Pablo-Jean/Antares-Transmitter-HWR/Output/1.0.2/3D/Antares-Transmitter.png

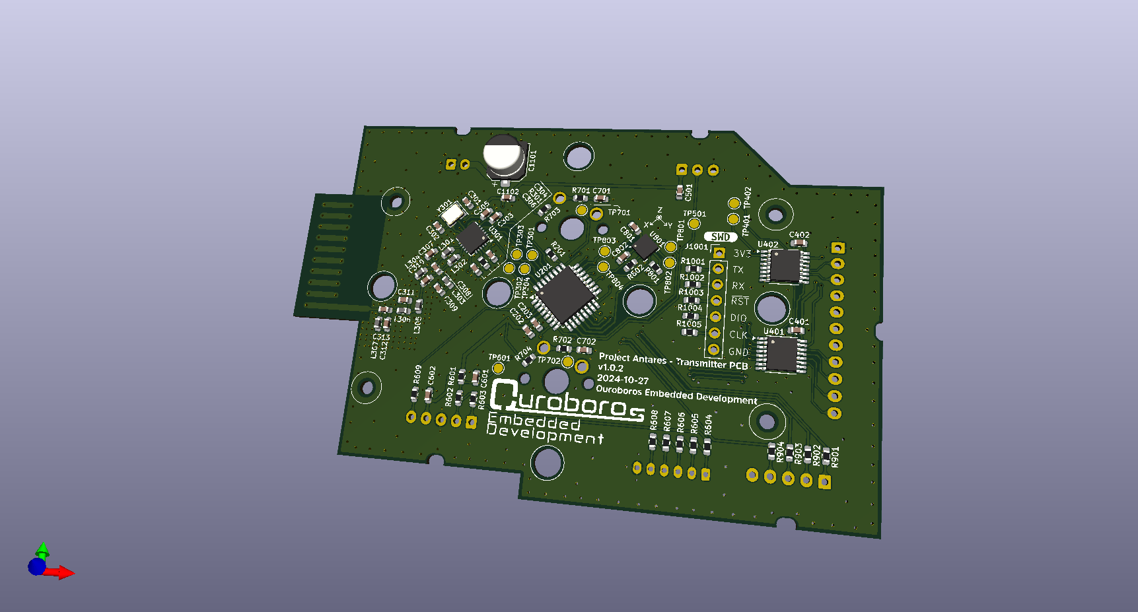
Output/1.0.2/3D/Antares-Transmitter.png
