Pablo-Jean/Antares-Transmitter-HWR/Calcs/Notes Btn An Calculations.ods

Sheet: Notes
Vin | R1 | R2 | R3 | R4 | R5 | R6 | R7 | R8 | R9 | R10 | R11
3,3 | 22 | 1 | 2,2 | 3,3 | 3,3 | 3,3 | 4,7 | 5,6 | 10 | 10 | 22
Chave | Tensão | Diferença
SW1 | 0,143 | 0,275569358178054
SW2 | 0,419 | 0,333583959899749
SW3 | 0,753 | 0,264349553128103
SW4 | 1,017 | 0,21464279954846
SW5 | 1,232 | 0,244255465360993
SW6 | 1,476 | 0,225001660283798
SW7 | 1,701 | 0,288649628651855
SW8 | 1,990 | 0,200377570960156
SW9 | 2,190 | 0,279428127558626
SW10 | 2,469

Sheet: Control
Vin | R1 | R2 | R3 | R4 | R5 | R6 | R7 | R8
3,3 | 10 | 1 | 2,2 | 3,3 | 5,6 | 5,6 | 10 | 22
Chave | Tensão | Diferença
SW1 | 0,300 | 0,5
SW2 | 0,800 | 0,5
SW3 | 1,300 | 0,506787330316742
SW4 | 1,807 | 0,301876929611056
SW5 | 2,109 | 0,316004175085465
SW6 | 2,425 | 0,32256774589126
SW7 | 2,747
