Pablo-Jean/Antares-Transmitter-HWR/Output/1.0.2/Schematic/Project Antares Transmitter Schematic v1.0.2.pdf

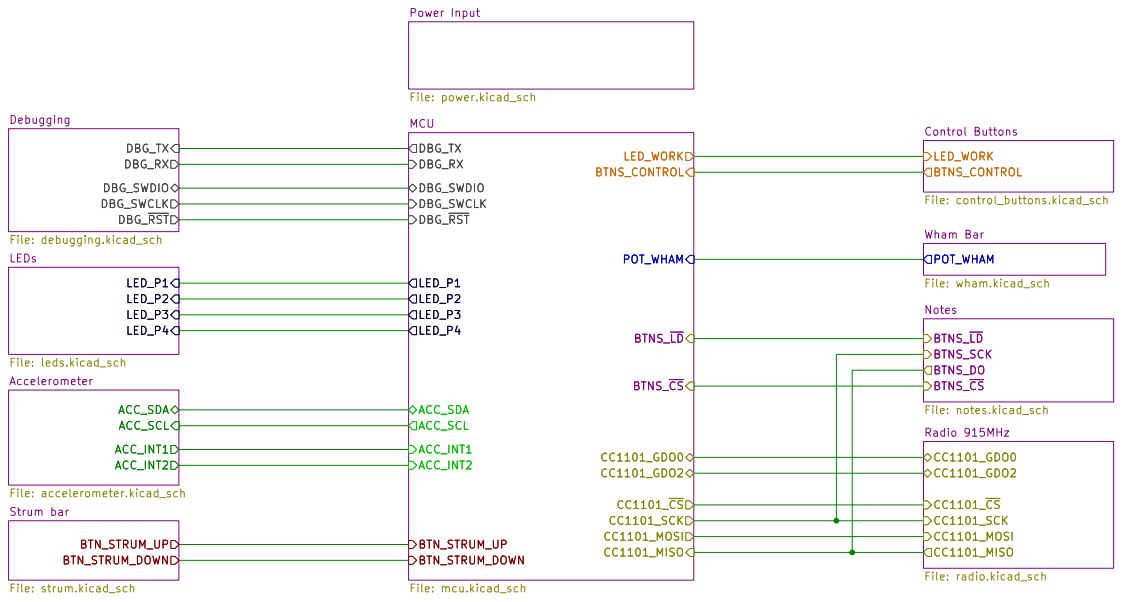
[picture p2: page 1]

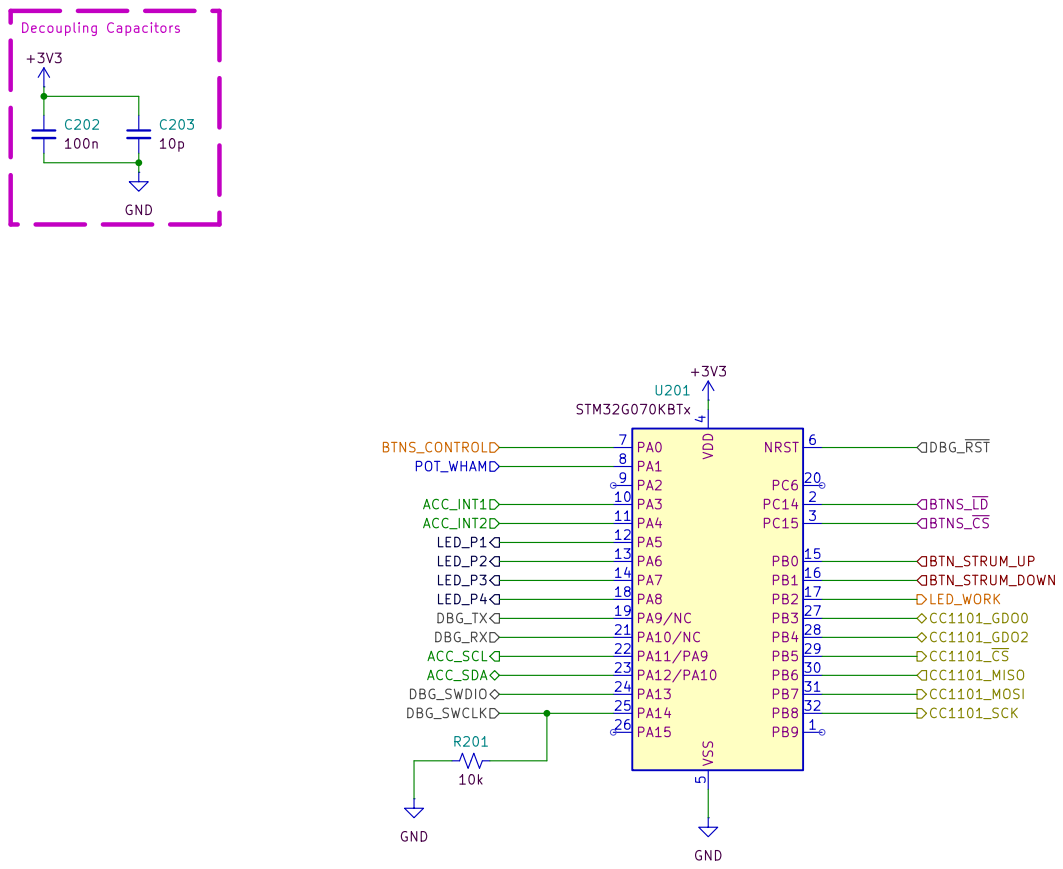
[picture p3: page 2]

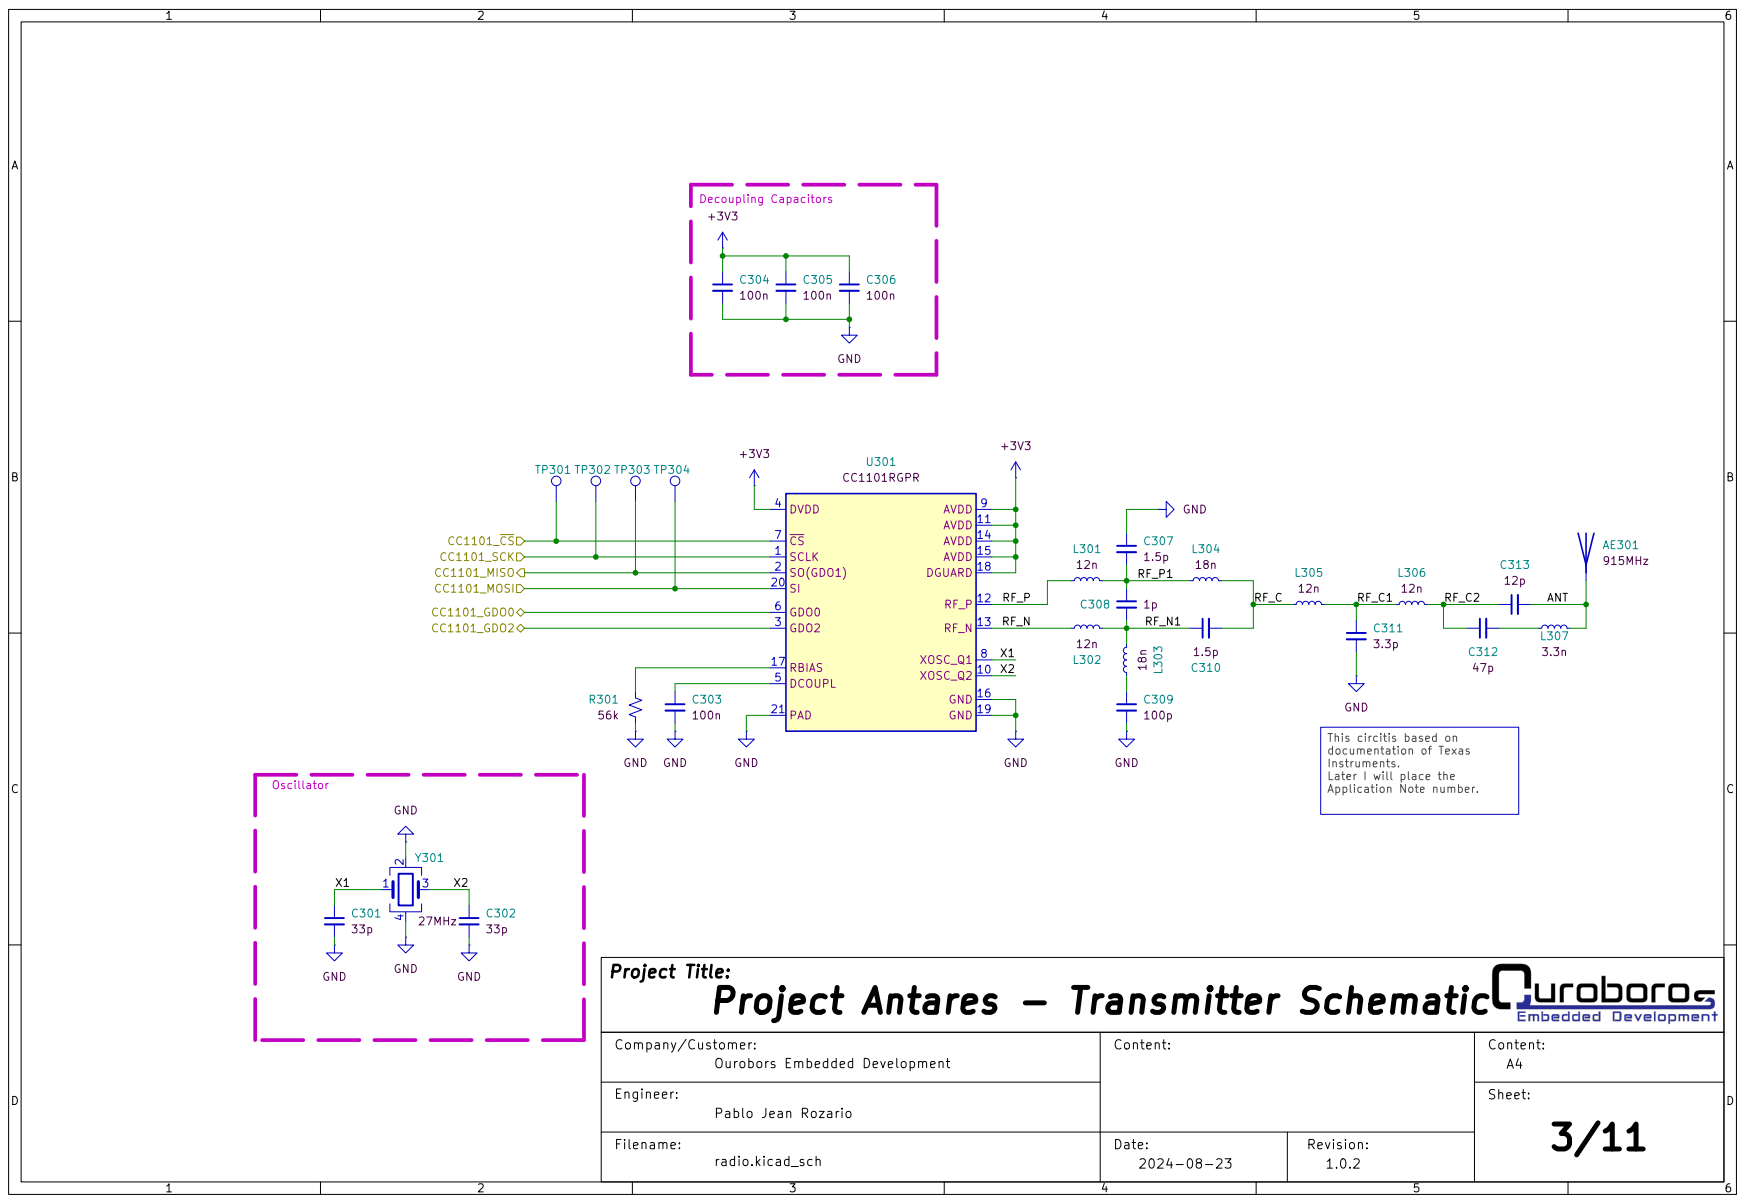
[picture p4: page 3]

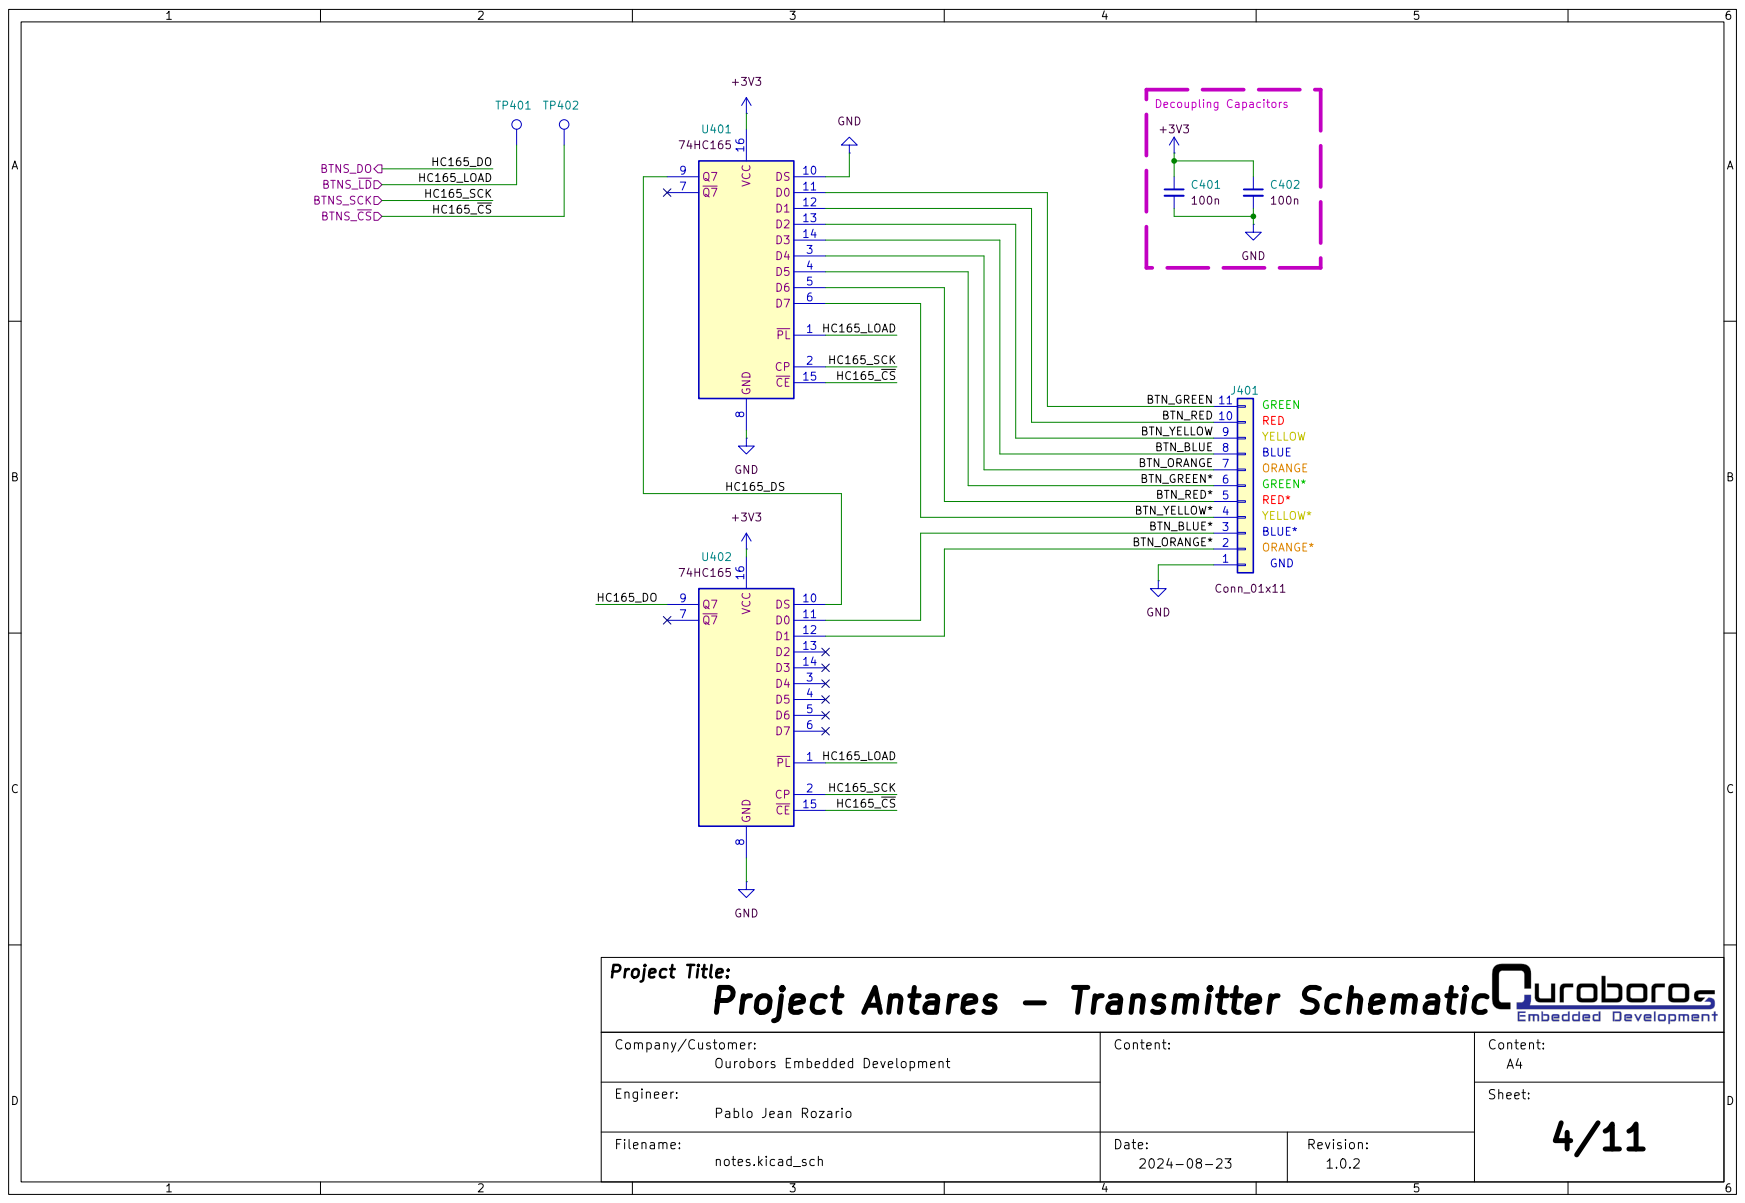
[picture p5: page 4]

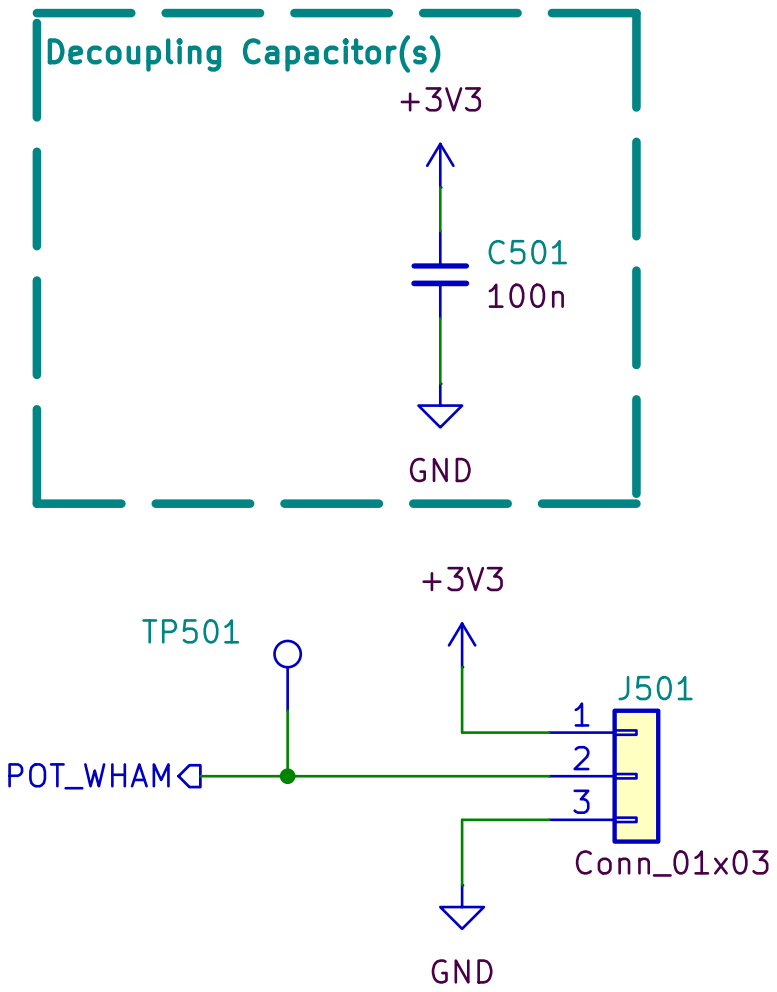
[picture p6: page 5]

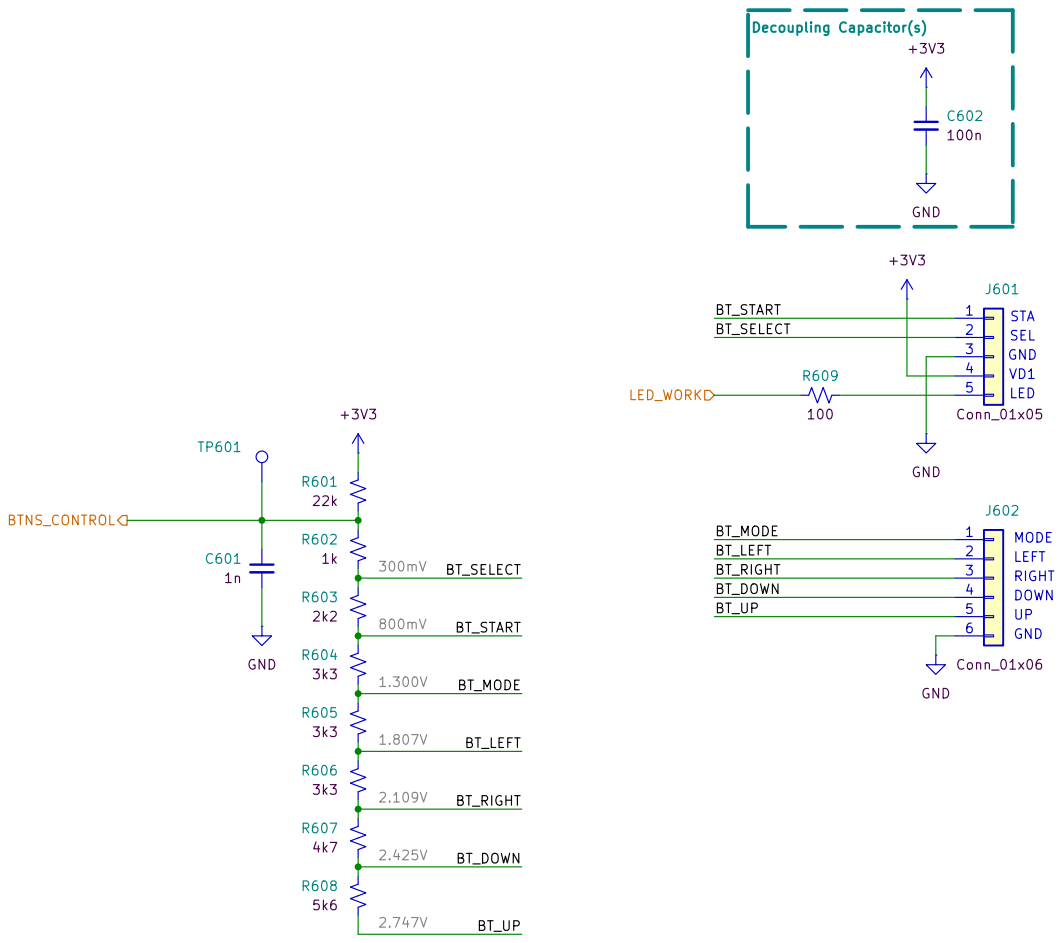
[picture p7: page 6]

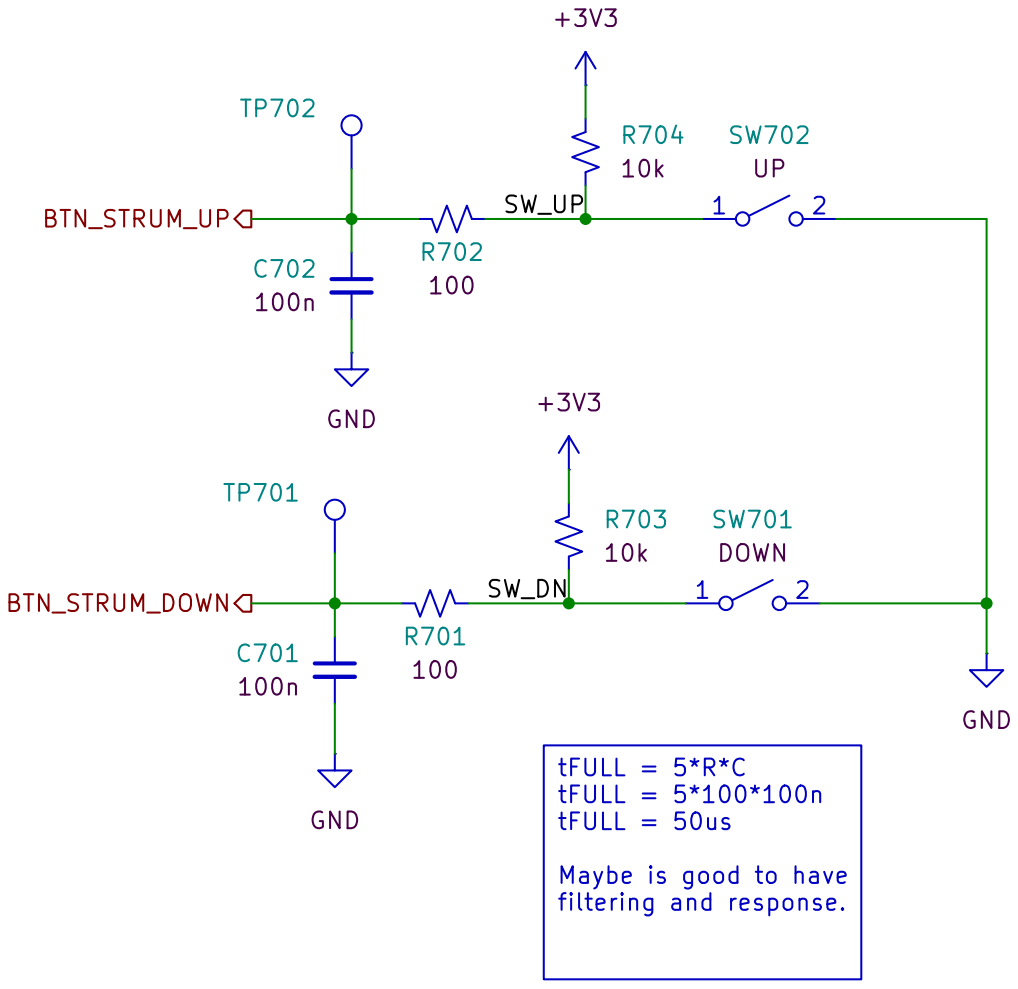
[picture p8: page 7]

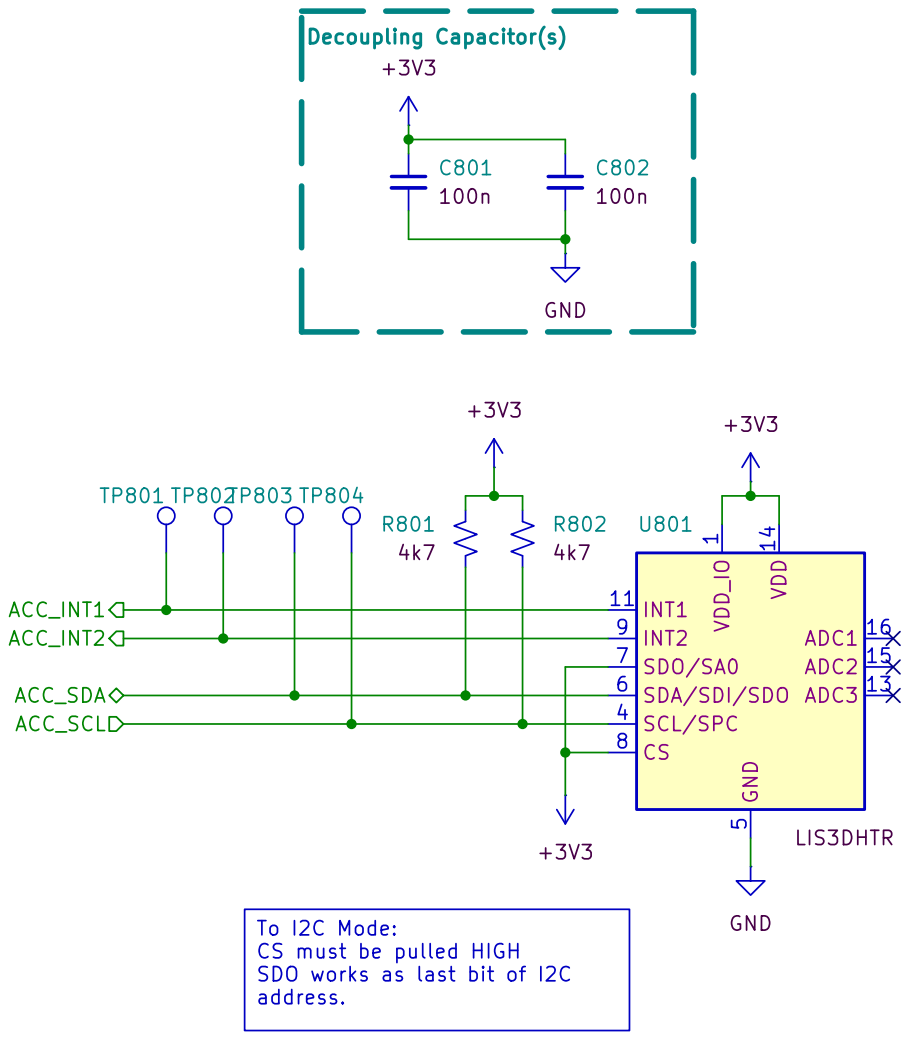
[picture p9: page 8]

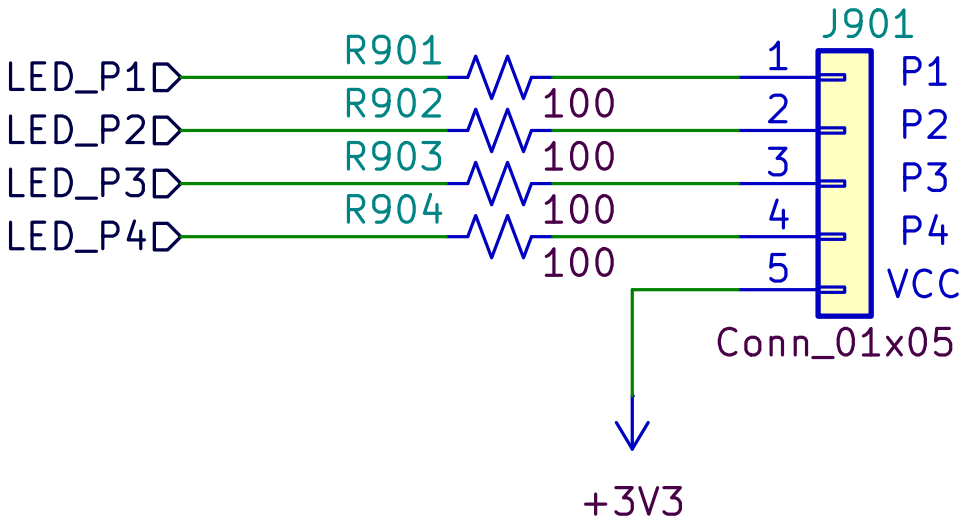
[picture p10: page 9]

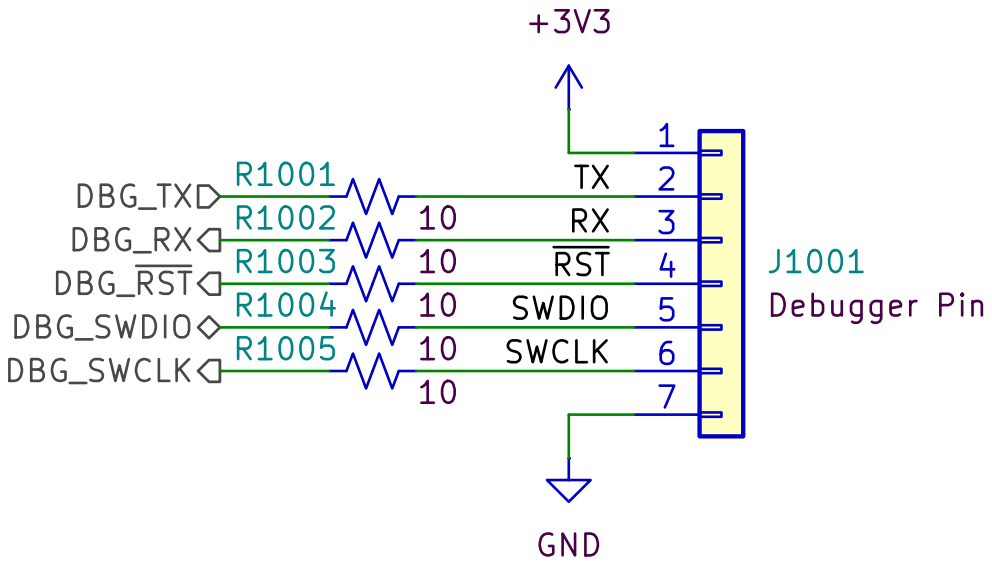
[picture p11: page 10]

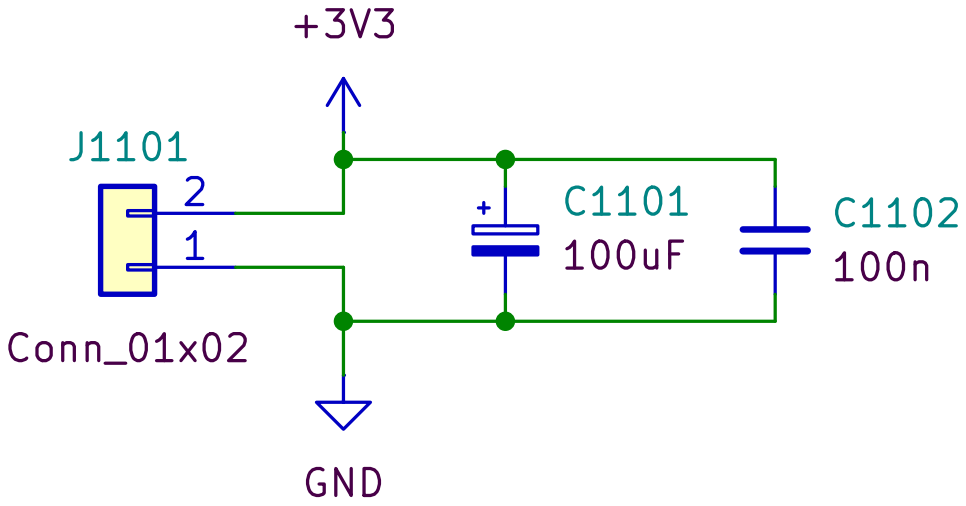
[picture p12: page 11]
