Pablo-Jean/Antares-Transmitter-HWR/Output/1.0.1/Schematic/Project Antares Transmitter Schematic v1.0.1.pdf

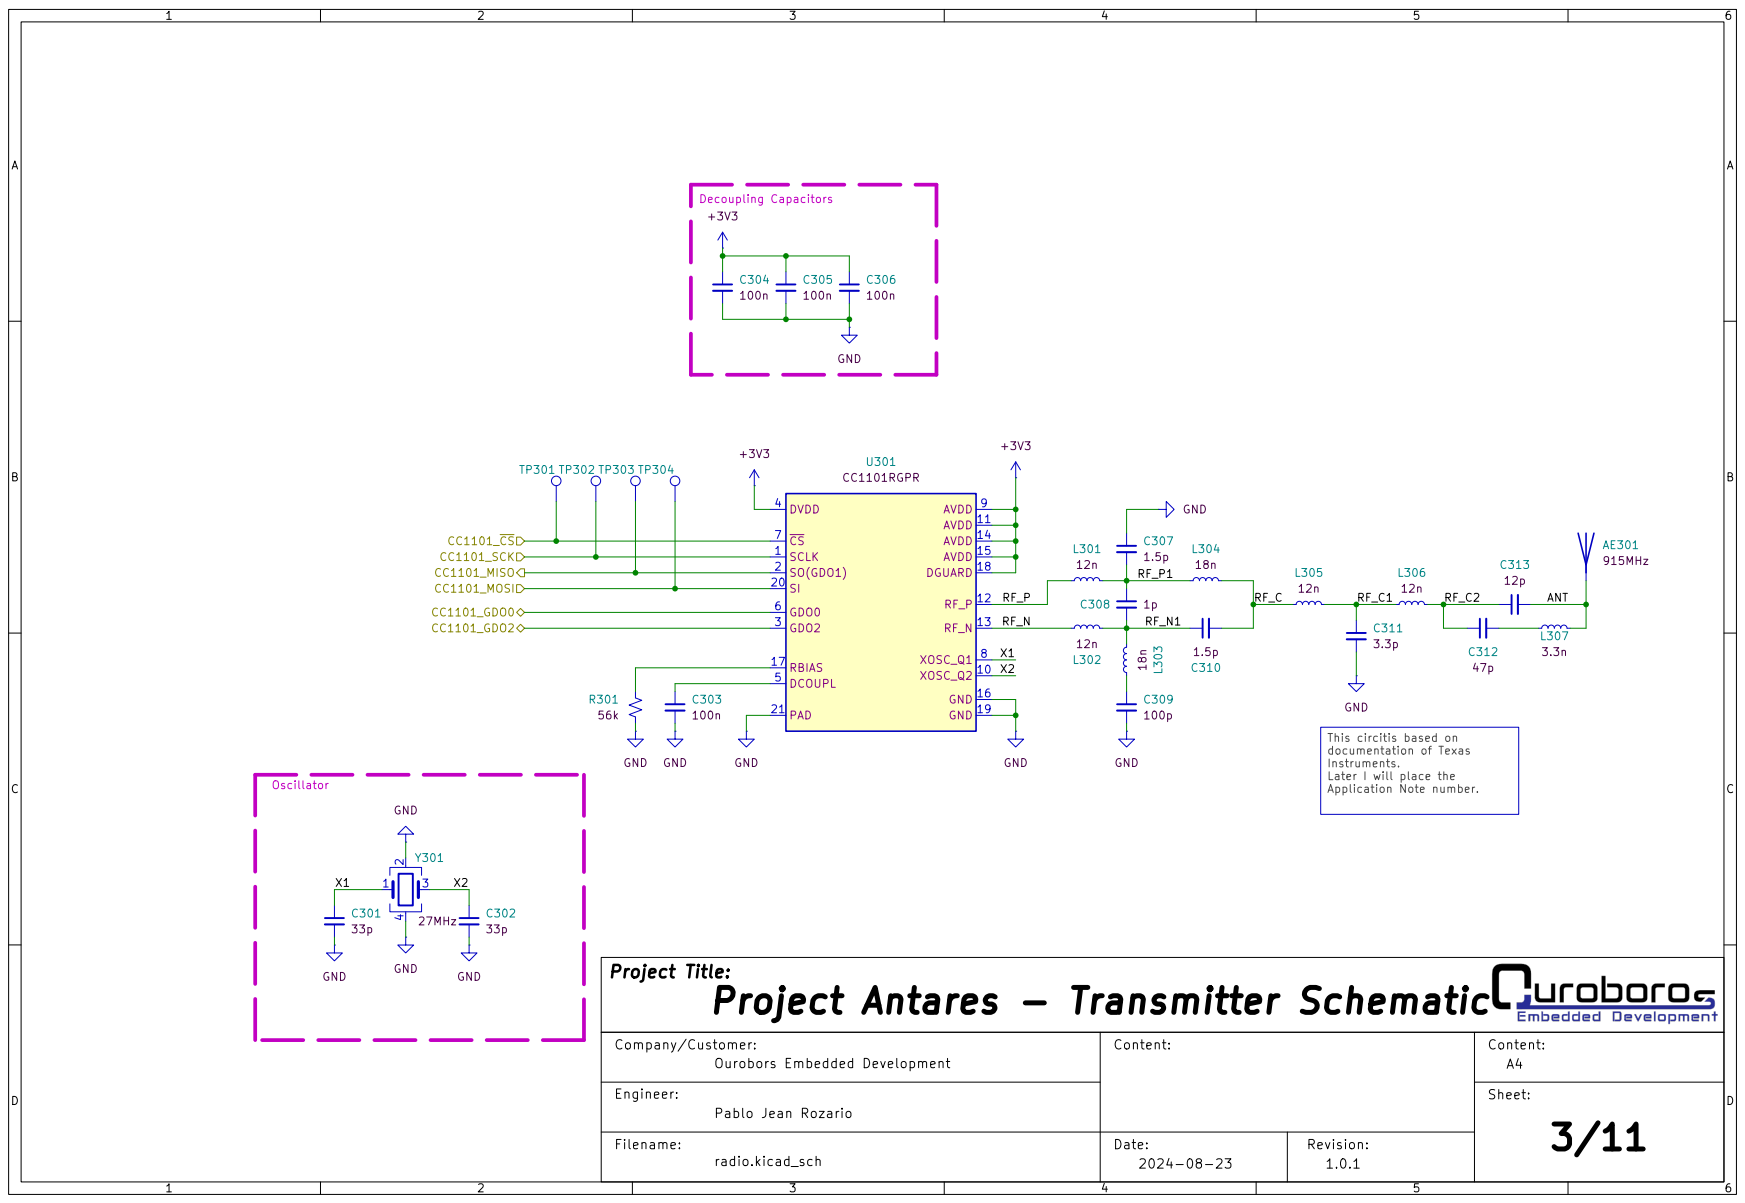
[picture p13: page 3]

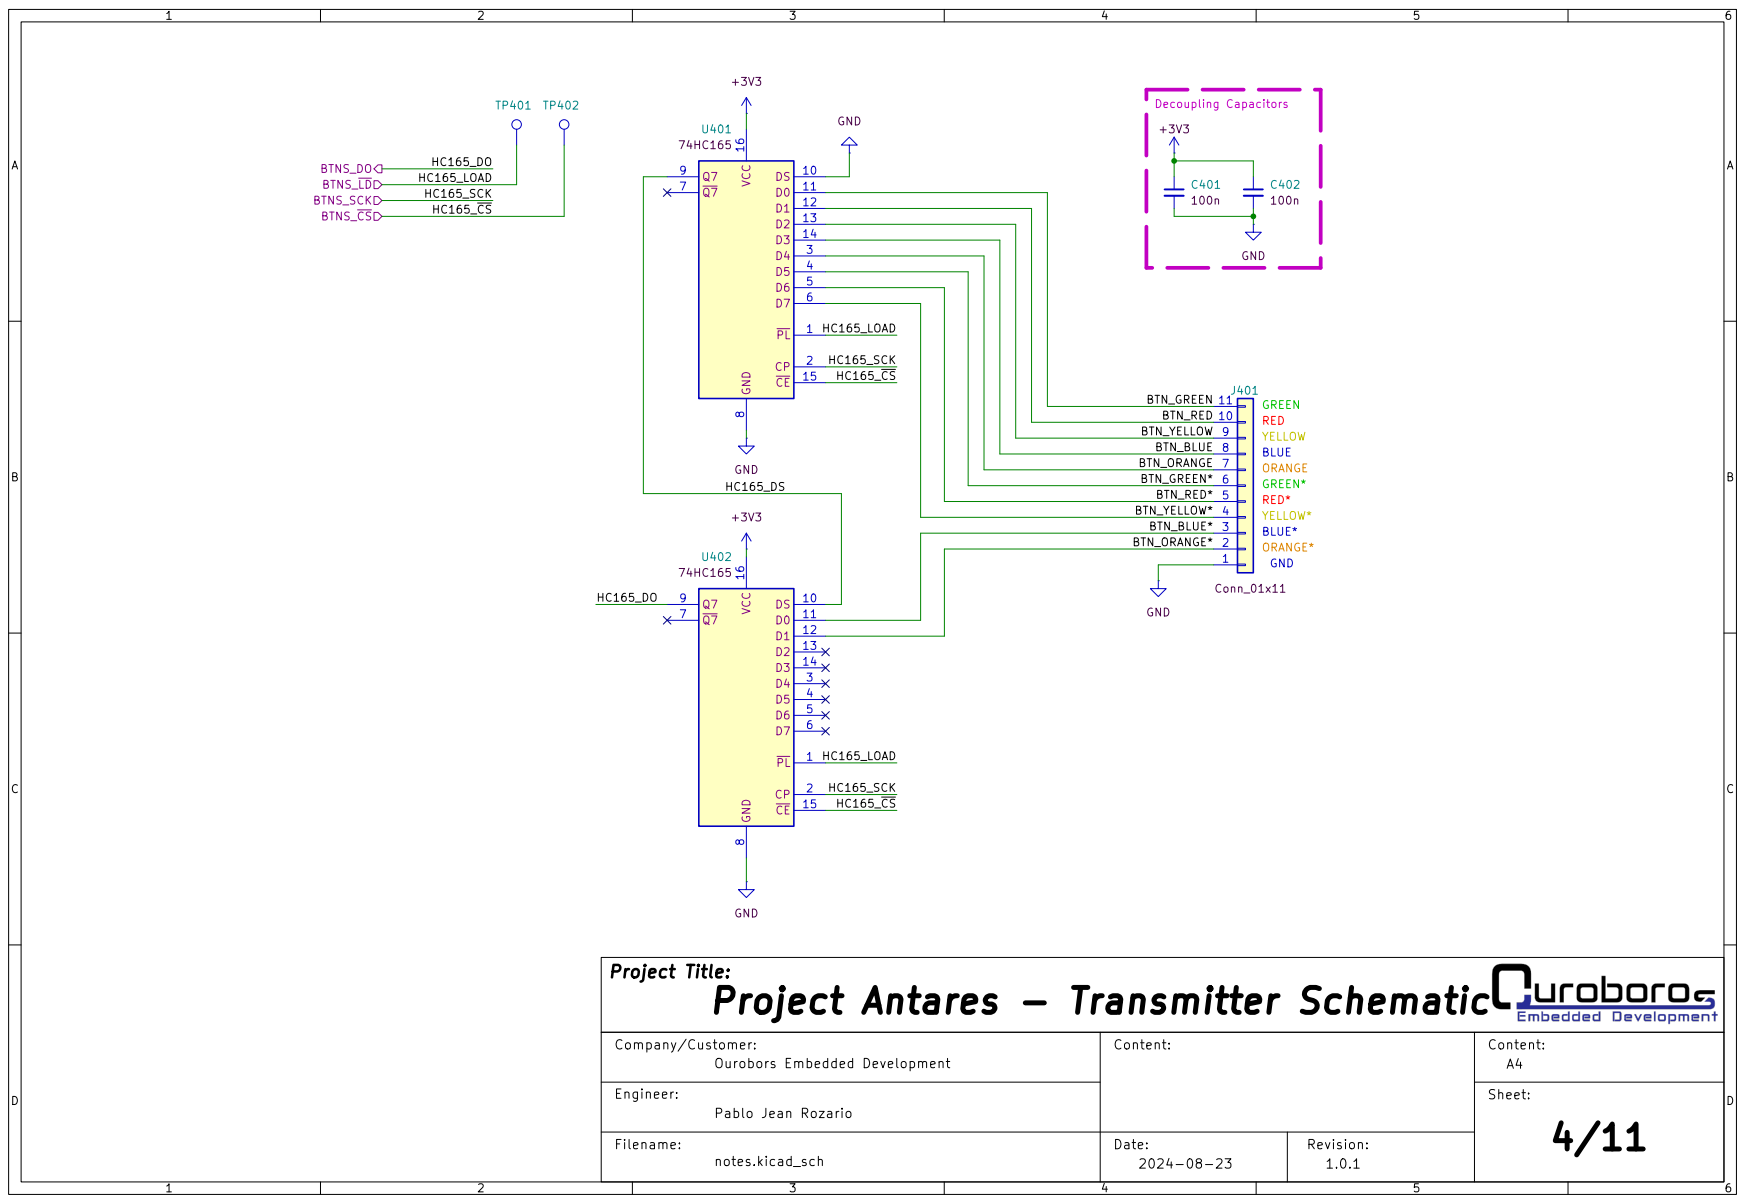
[picture p14: page 4]
