Pablo-Jean/Antares-Transmitter-HWR/Output/1.0.0/Schematic/Project Antares v1.0.0 Schematic.pdf

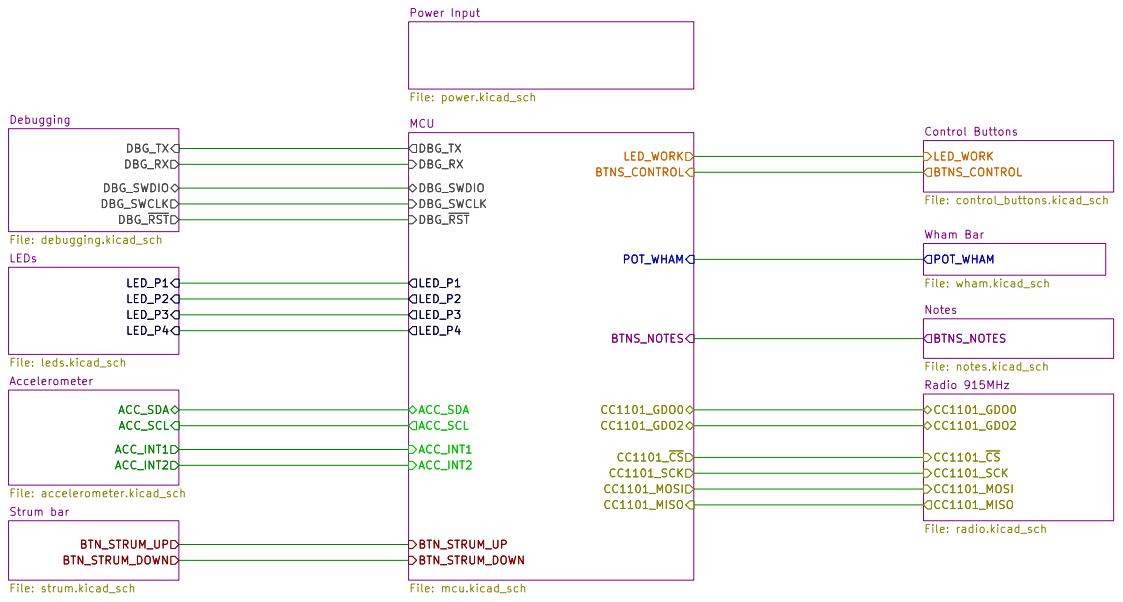
[picture p15: page 1]

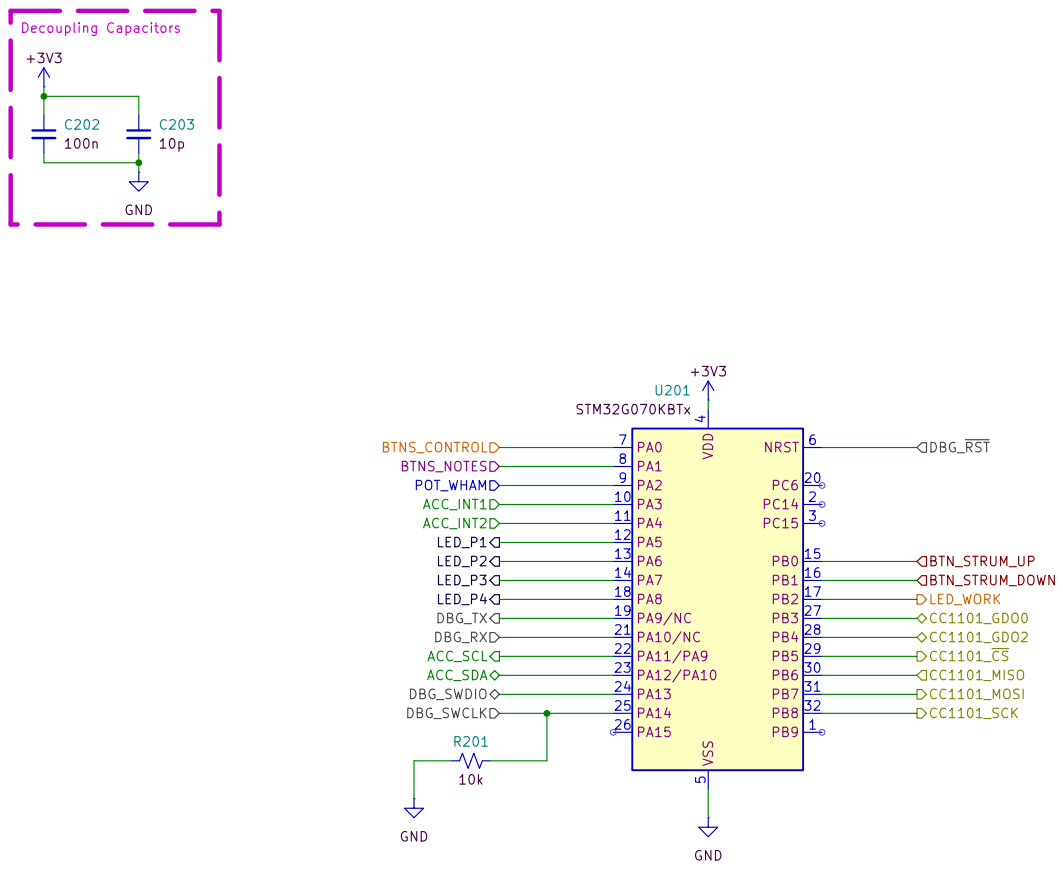
[picture p16: page 2]

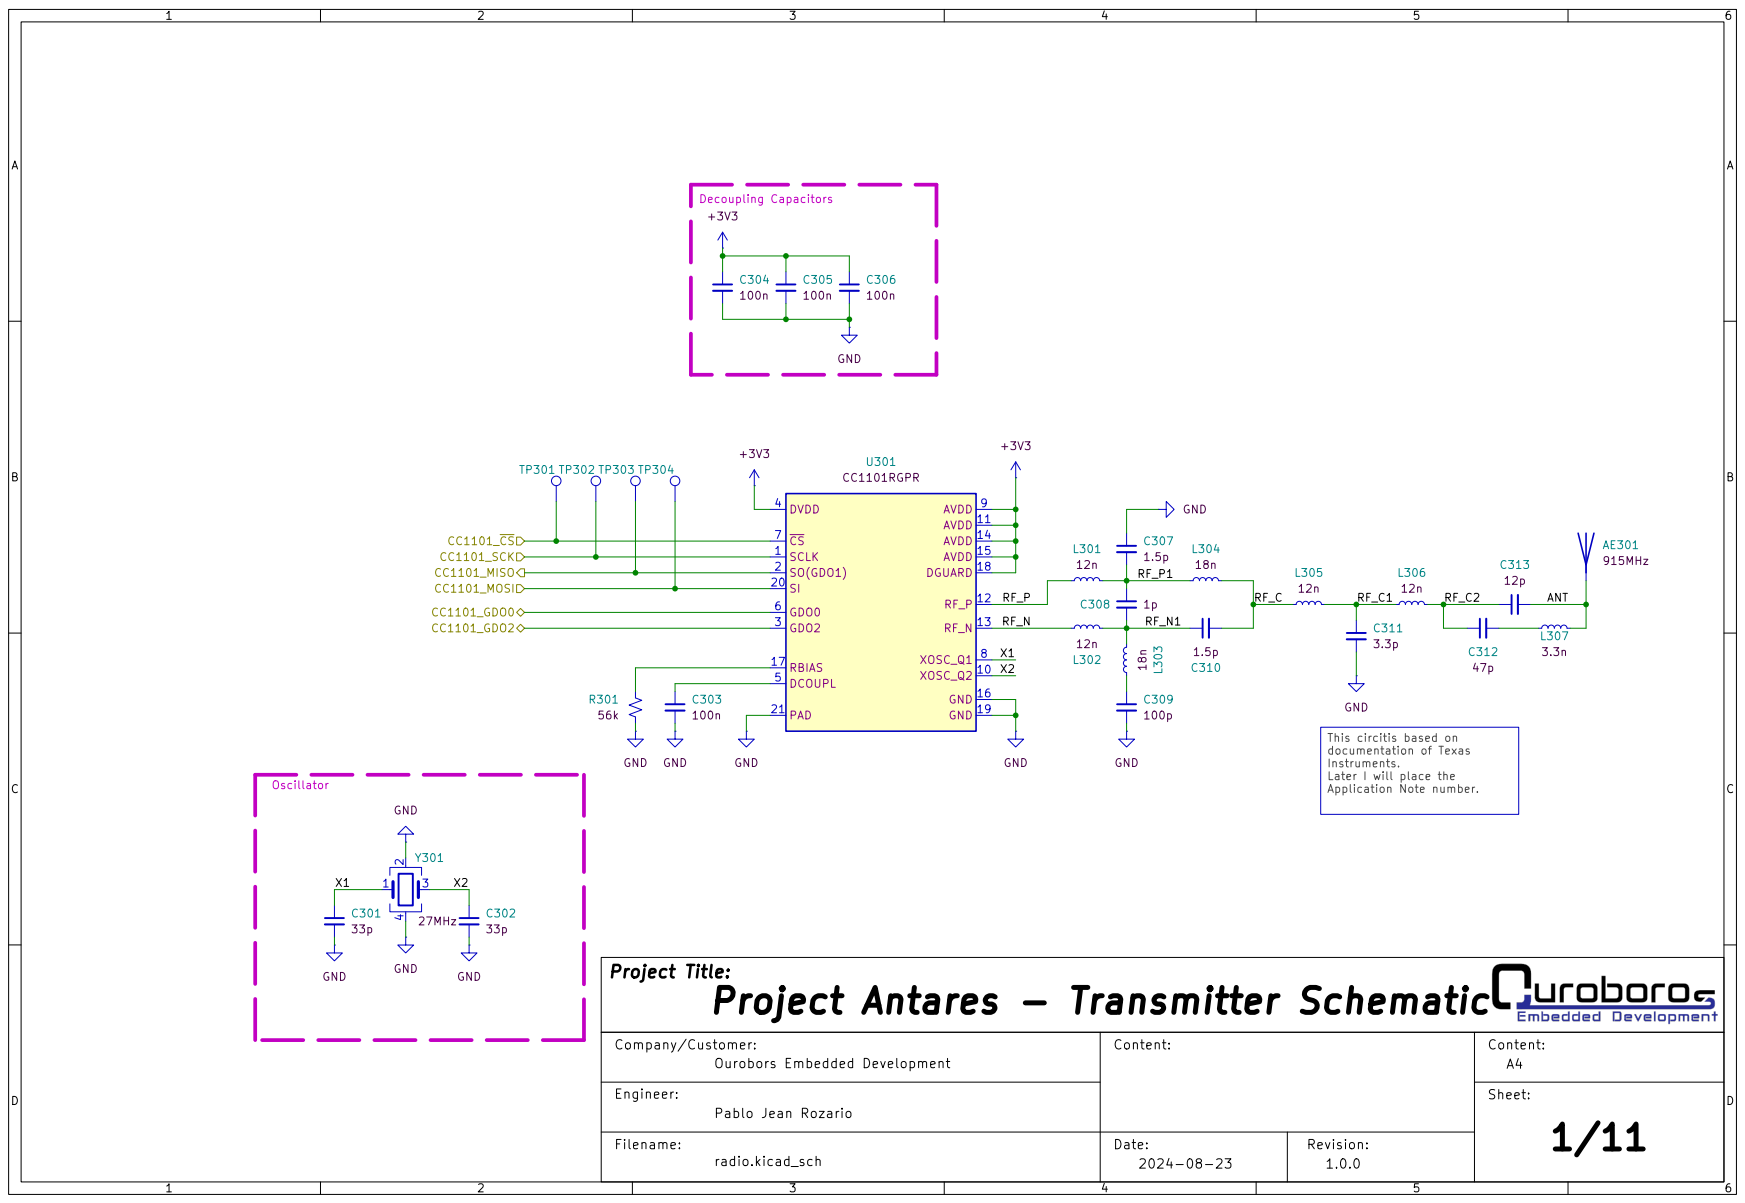
[picture p17: page 3]

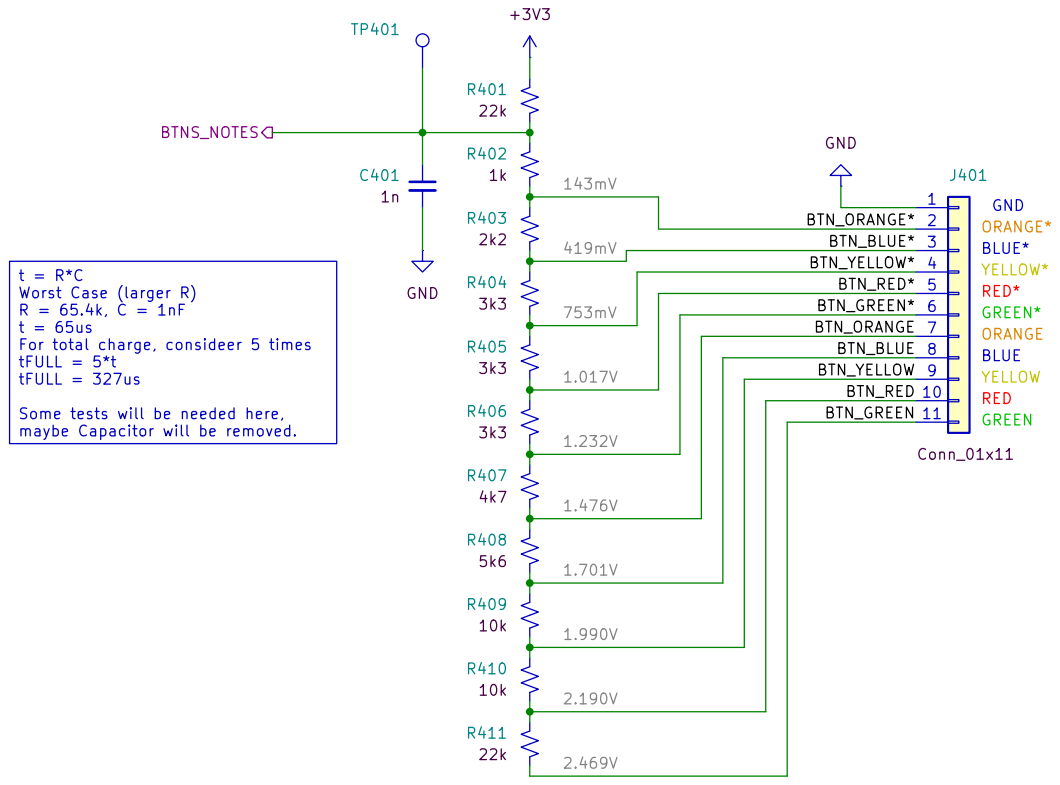
[picture p18: page 4]
