Pablo-Jean/Antares-Transmitter-HWR/Antares-Transmitter.kicad_pcb

## KiCad design Antares-Transmitter.kicad_pcb (2025-12-22)

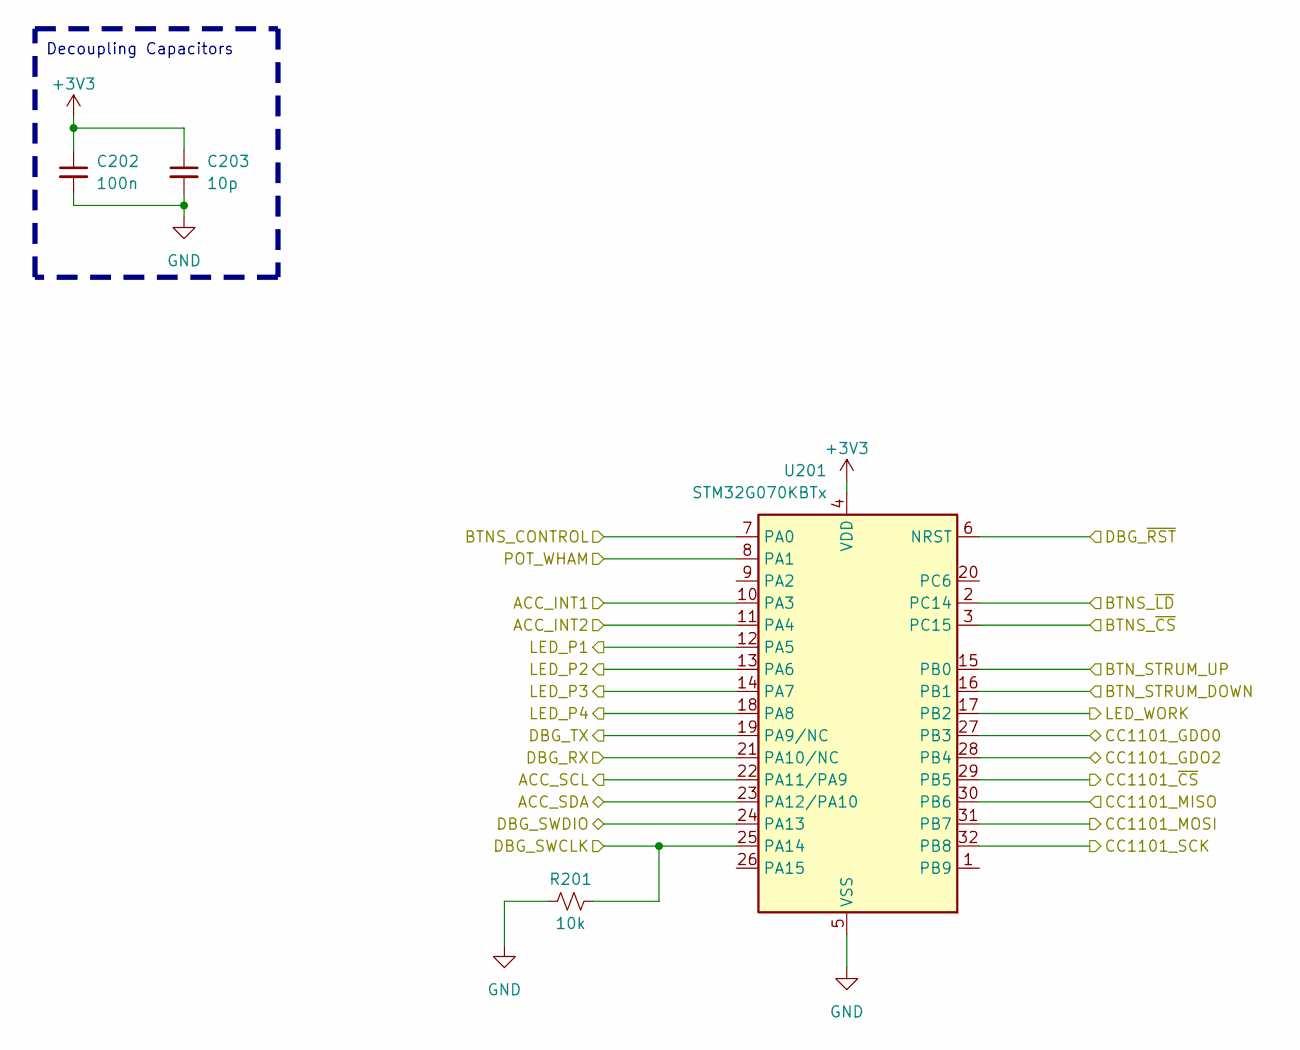
[picture p19: schematic mcu.kicad_sch, Project Antares - Transmitter Schematic]

Parts:
C202: 100n; C_0603_1608Metric; LCSC C14663
C203: 10p; C_0603_1608Metric; LCSC C1634
R201: 10k; R_0603_1608Metric; LCSC C25804
U201: STM32G070KBTx; LQFP-32_7x7mm_P0.8mm; LCSC C529339

Connections:
+3V3: C202.1, C203.1, U201.4 (VDD); also elsewhere on the board
/Accelerometer/ACC_INT1: U201.10 (PA3); also elsewhere on the board
/Accelerometer/ACC_INT2: U201.11 (PA4); also elsewhere on the board
/Accelerometer/ACC_SCL: U201.22 (PA11/PA9); also elsewhere on the board
/Accelerometer/ACC_SDA: U201.23 (PA12/PA10); also elsewhere on the board
/Control Buttons/BTNS_CONTROL: U201.7 (PA0); also elsewhere on the board
/Control Buttons/LED_WORK: U201.17 (PB2); also elsewhere on the board
/Debugging/DBG_RX: U201.21 (PA10/NC); also elsewhere on the board
/Debugging/DBG_SWCLK: R201.2, U201.25 (PA14); also elsewhere on the board
/Debugging/DBG_SWDIO: U201.24 (PA13); also elsewhere on the board
/Debugging/DBG_TX: U201.19 (PA9/NC); also elsewhere on the board
/Debugging/DBG_~RST: U201.6 (NRST); also elsewhere on the board
/LEDs/LED_P1: U201.12 (PA5); also elsewhere on the board
/LEDs/LED_P2: U201.13 (PA6); also elsewhere on the board
/LEDs/LED_P3: U201.14 (PA7); also elsewhere on the board
/LEDs/LED_P4: U201.18 (PA8); also elsewhere on the board
/MCU/BTN_STRUM_DOWN: U201.16 (PB1); also elsewhere on the board
/MCU/BTN_STRUM_UP: U201.15 (PB0); also elsewhere on the board
/MCU/CC1101_GDO0: U201.27 (PB3); also elsewhere on the board
/MCU/CC1101_GDO2: U201.28 (PB4); also elsewhere on the board
/MCU/CC1101_MOSI: U201.31 (PB7); also elsewhere on the board
/MCU/CC1101_~CS: U201.29 (PB5); also elsewhere on the board
/MCU/POT_WHAM: U201.8 (PA1); also elsewhere on the board
/Notes/HC165_DO: U201.30 (PB6); also elsewhere on the board
/Notes/HC165_LOAD: U201.2 (PC14); also elsewhere on the board
/Notes/HC165_SCK: U201.32 (PB8); also elsewhere on the board
/Notes/HC165_~CS: U201.3 (PC15); also elsewhere on the board
GND: C202.2, C203.2, R201.1, U201.5 (VSS); also elsewhere on the board

Notes on the sheet:
Decoupling Capacitors

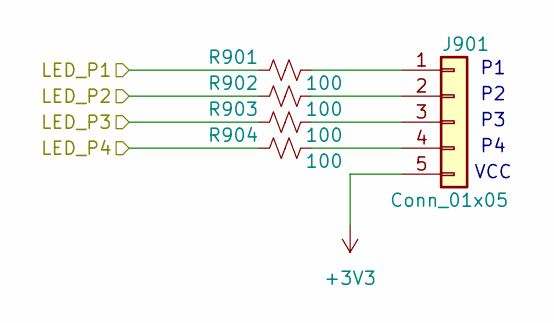
[picture p20: schematic leds.kicad_sch, Project Antares - Transmitter Schematic]

Parts:
J901: Conn_01x05; JST_XH_S5B-XH-A-1_1x05_P2.50mm_Horizontal; LCSC C2845508
R901, R902, R903, R904: 100; R_0603_1608Metric; LCSC C22775

Connections:
+3V3: J901.5; also elsewhere on the board
/LEDs/LED_P1: R901.1; also elsewhere on the board
/LEDs/LED_P2: R902.1; also elsewhere on the board
/LEDs/LED_P3: R903.1; also elsewhere on the board
/LEDs/LED_P4: R904.1; also elsewhere on the board
unnamed: J901.1, R901.2
unnamed: J901.2, R902.2
unnamed: J901.3, R903.2
unnamed: J901.4, R904.2

Notes on the sheet:
VCC

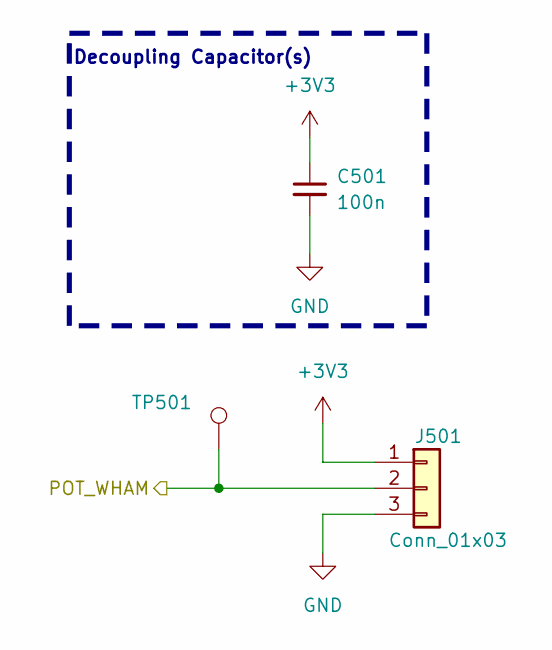
[picture p21: schematic wham.kicad_sch, Project Antares - Transmitter Schematic]

Parts:
C501: 100n; C_0603_1608Metric; LCSC C14663
J501: Conn_01x03; JST_XH_S3B-XH-A-1_1x03_P2.50mm_Horizontal; LCSC C2845506
TP501: TestPoint; TestPoint_Pad_D1.5mm

Connections:
+3V3: C501.1, J501.1; also elsewhere on the board
/MCU/POT_WHAM: J501.2, TP501.1; also elsewhere on the board
GND: C501.2, J501.3; also elsewhere on the board

Notes on the sheet:
Decoupling Capacitor(s)

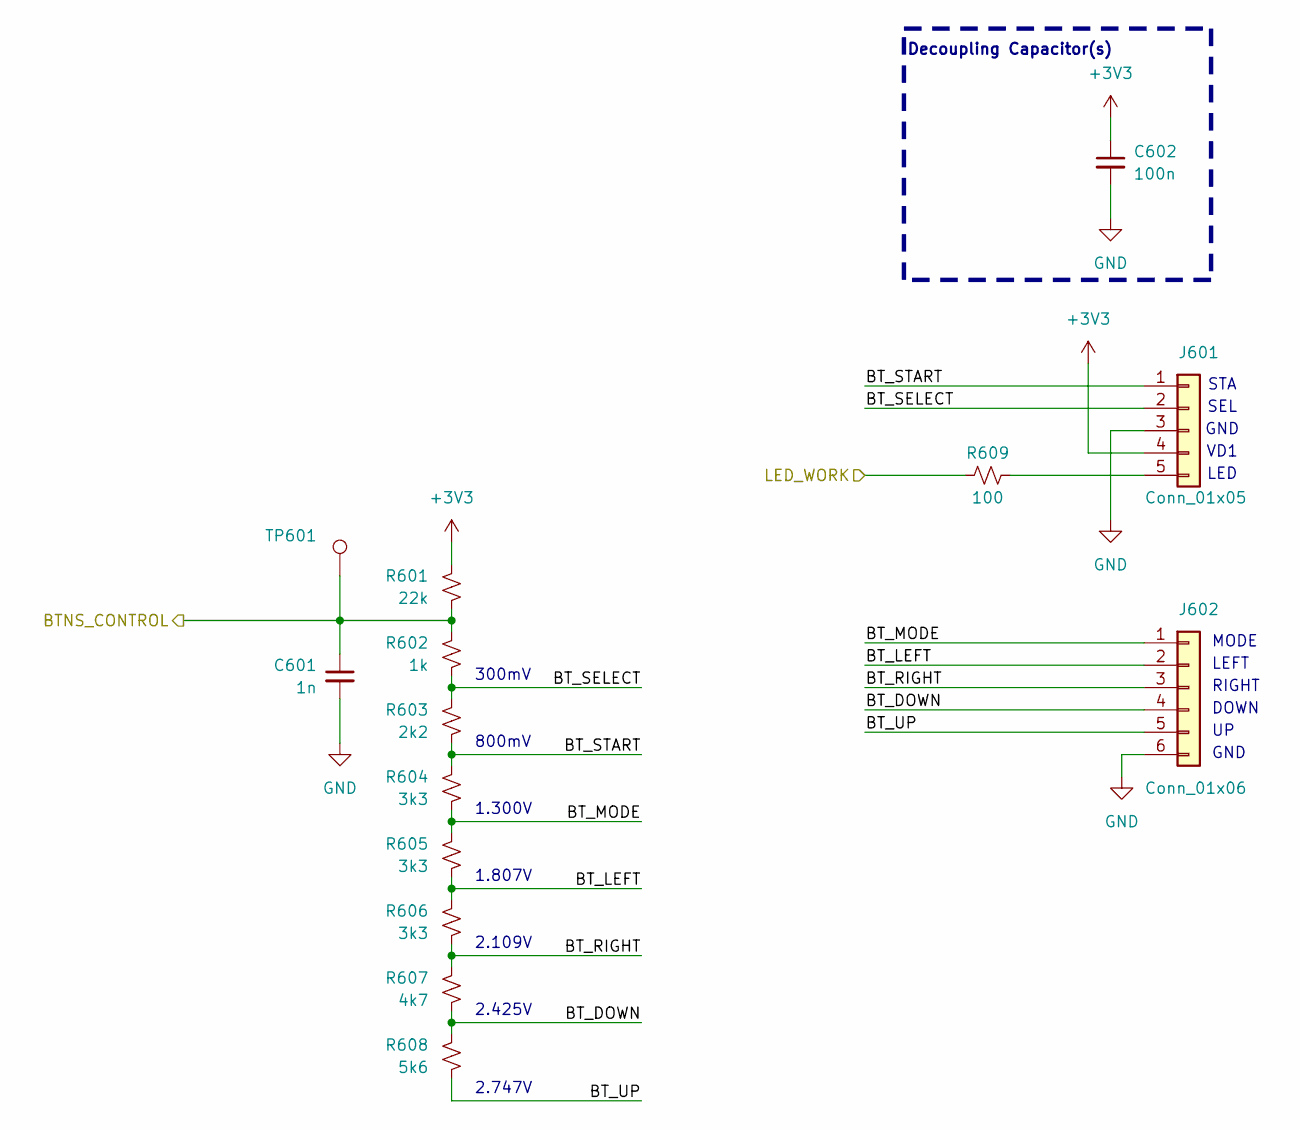
[picture p22: schematic control_buttons.kicad_sch, Project Antares - Transmitter Schematic]

Parts:
C601: 1n; C_0603_1608Metric; LCSC C1588
C602: 100n; C_0603_1608Metric; LCSC C14663
J601: Conn_01x05; JST_XH_S5B-XH-A-1_1x05_P2.50mm_Horizontal; LCSC C2845508
J602: Conn_01x06; JST_PH_S6B-PH-K_1x06_P2.00mm_Horizontal; LCSC C2908638
R601: 22k; R_0603_1608Metric; LCSC C31850
R602: 1k; R_0603_1608Metric; LCSC C21190
R603: 2k2; R_0603_1608Metric; LCSC C4190
R604, R605, R606: 3k3; R_0603_1608Metric; LCSC C22978
R607: 4k7; R_0603_1608Metric; LCSC C23162
R608: 5k6; R_0603_1608Metric; LCSC C23189
R609: 100; R_0603_1608Metric; LCSC C22775
TP601: TestPoint; TestPoint_Pad_D1.5mm

Connections:
+3V3: C602.1, J601.4, R601.1; also elsewhere on the board
/Control Buttons/BTNS_CONTROL: C601.1, R601.2, R602.1, TP601.1; also elsewhere on the board
/Control Buttons/BT_DOWN: J602.4, R607.2, R608.1
/Control Buttons/BT_LEFT: J602.2, R605.2, R606.1
/Control Buttons/BT_MODE: J602.1, R604.2, R605.1
/Control Buttons/BT_RIGHT: J602.3, R606.2, R607.1
/Control Buttons/BT_SELECT: J601.2, R602.2, R603.1
/Control Buttons/BT_START: J601.1, R603.2, R604.1
/Control Buttons/BT_UP: J602.5, R608.2
/Control Buttons/LED_WORK: R609.1; also elsewhere on the board
GND: C601.2, C602.2, J601.3, J602.6; also elsewhere on the board
unnamed: J601.5, R609.2

Notes on the sheet:
SEL
1.807V
VD1
RIGHT
MODE
800mV
Decoupling Capacitor(s)
1.300V
GND
LEFT
2.425V
STA
DOWN
300mV
LED
2.109V
2.747V

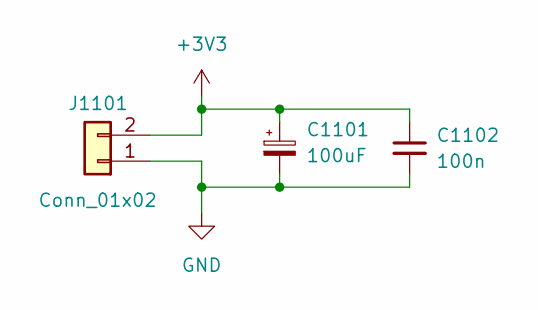
[picture p23: schematic power.kicad_sch, Project Antares - Transmitter Schematic]

Parts:
C1101: 100uF; CP_Elec_6.3x4.5; LCSC C5374787
C1102: 100n; C_0603_1608Metric; LCSC C14663
J1101: Conn_01x02; JST_XH_S2B-XH-A-1_1x02_P2.50mm_Horizontal; LCSC C33132

Connections:
+3V3: C1101.1, C1102.1, J1101.2; also elsewhere on the board
GND: C1101.2, C1102.2, J1101.1; also elsewhere on the board

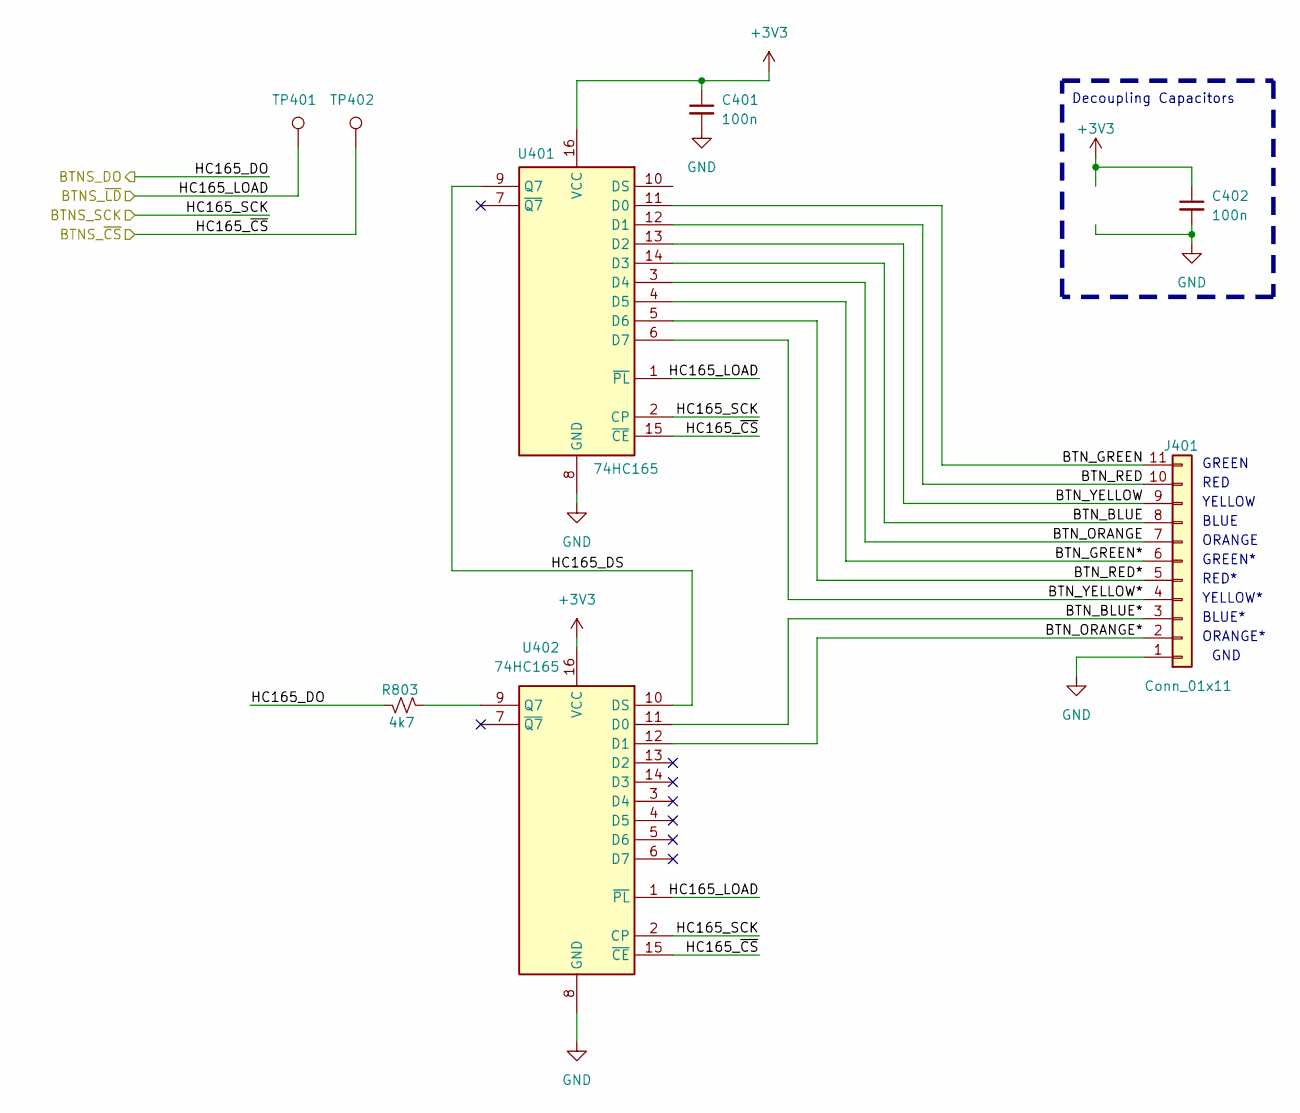
[picture p24: schematic notes.kicad_sch, Project Antares - Transmitter Schematic]

Parts:
C401, C402: 100n; C_0603_1608Metric; LCSC C14663
J401: Conn_01x11; JST_XH_S11B-XH-A-1_1x11_P2.50mm_Horizontal; LCSC C2845514
R803: 4k7; R_0603_1608Metric; LCSC C23162
TP401, TP402: TestPoint; TestPoint_Pad_D1.5mm
U401, U402: 74HC165; TSSOP-16_4.4x5mm_P0.65mm; LCSC C80696

Connections:
+3V3: C401.1, C402.1, U401.16 (VCC), U402.16 (VCC); also elsewhere on the board
/Notes/BTN_BLUE: J401.8, U401.14 (D3)
/Notes/BTN_BLUE*: J401.3, U402.11 (D0)
/Notes/BTN_GREEN: J401.11, U401.11 (D0)
/Notes/BTN_GREEN*: J401.6, U401.4 (D5)
/Notes/BTN_ORANGE: J401.7, U401.3 (D4)
/Notes/BTN_ORANGE*: J401.2, U402.12 (D1)
/Notes/BTN_RED: J401.10, U401.12 (D1)
/Notes/BTN_RED*: J401.5, U401.5 (D6)
/Notes/BTN_YELLOW: J401.9, U401.13 (D2)
/Notes/BTN_YELLOW*: J401.4, U401.6 (D7)
/Notes/HC165_DS: U401.9 (Q7), U402.10 (DS)
/Notes/HC165_LOAD: TP401.1, U401.1 (~PL), U402.1 (~PL); also elsewhere on the board
/Notes/HC165_SCK: U401.2 (CP), U402.2 (CP); also elsewhere on the board
/Notes/HC165_~CS: TP402.1, U401.15 (~CE), U402.15 (~CE); also elsewhere on the board
GND: C401.2, C402.2, J401.1, U401.8 (GND), U401.10 (DS), U402.8 (GND); also elsewhere on the board
unnamed: R803.2, U402.9 (Q7)

Notes on the sheet:
ORANGE*
GREEN
YELLOW
ORANGE
YELLOW*
GREEN*
BLUE
GND
Decoupling Capacitors
RED
RED*
BLUE*

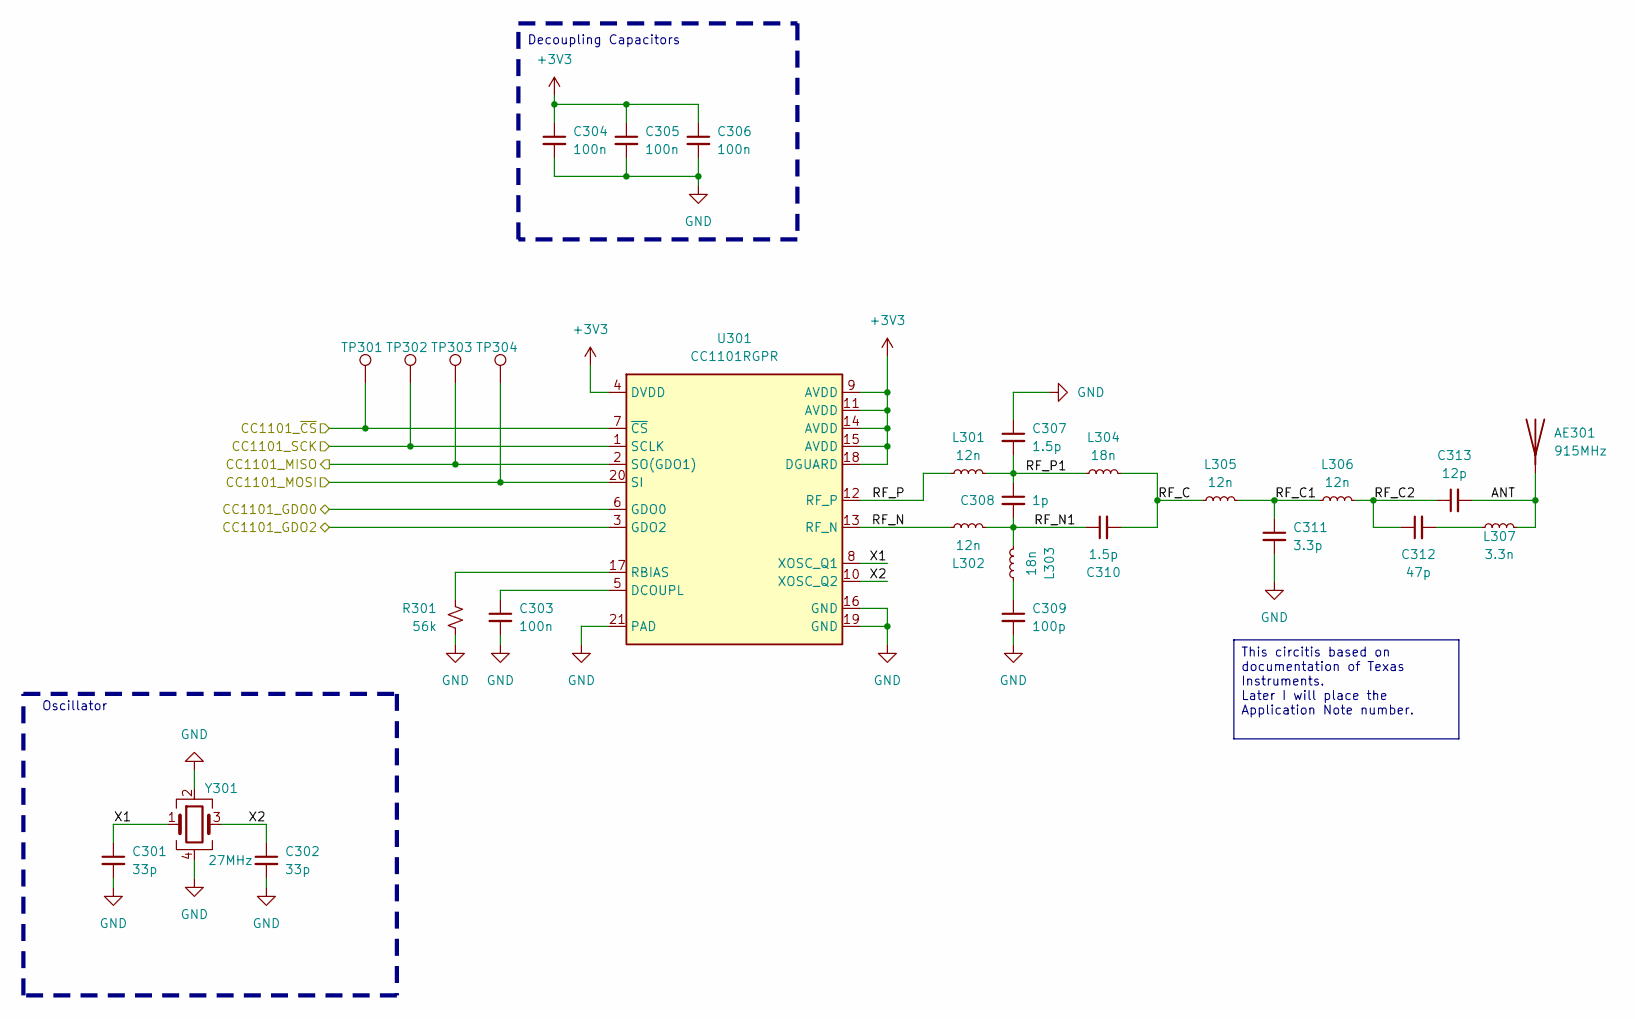
[picture p25: schematic radio.kicad_sch, Project Antares - Transmitter Schematic]

Parts:
AE301: 915MHz; Texas_SWRA416_868MHz_915MHz
C301, C302: 33p; C_0603_1608Metric; LCSC C1663
C303, C304, C305, C306: 100n; C_0603_1608Metric; LCSC C14663
C307, C310: 1.5p; C_0603_1608Metric; LCSC C519100
C308: 1p; C_0603_1608Metric; LCSC C115062
C309: 100p; C_0603_1608Metric; LCSC C14858
C311: 3.3p; C_0603_1608Metric; LCSC C282249
C312: 47p; C_0603_1608Metric; LCSC C1671
C313: 12p; C_0603_1608Metric; LCSC C38523
L301, L302, L305, L306: 12n; L_0603_1608Metric; LCSC C75656
L303, L304: 18n; L_0603_1608Metric; LCSC C90206
L307: 3.3n; L_0603_1608Metric; LCSC C1029
R301: 56k; R_0603_1608Metric; LCSC C23206
TP301, TP302, TP303, TP304: TestPoint; TestPoint_Pad_D1.5mm
U301: CC1101RGPR; QFN-20-1EP_4x4mm_P0.5mm_EP2.5x2.5mm_ThermalVias; LCSC C29953
Y301: 27MHz; Crystal_SMD_3225-4Pin_3.2x2.5mm; LCSC C9008

Connections:
+3V3: C304.1, C305.1, C306.1, U301.4 (DVDD), U301.9 (AVDD), U301.11 (AVDD), U301.14 (AVDD), U301.15 (AVDD), U301.18 (DGUARD); also elsewhere on the board
/MCU/CC1101_GDO0: U301.6 (GDO0); also elsewhere on the board
/MCU/CC1101_GDO2: U301.3 (GDO2); also elsewhere on the board
/MCU/CC1101_MOSI: TP304.1, U301.20 (SI); also elsewhere on the board
/MCU/CC1101_~CS: TP301.1, U301.7 (~CS); also elsewhere on the board
/Notes/HC165_DO: TP303.1, U301.2 (SO(GDO1)); also elsewhere on the board
/Notes/HC165_SCK: TP302.1, U301.1 (SCLK); also elsewhere on the board
/Radio 915MHz/ANT: AE301.1 (A), C313.2, L307.2
/Radio 915MHz/RF_C: C310.2, L304.2, L305.1
/Radio 915MHz/RF_C1: C311.1, L305.2, L306.1
/Radio 915MHz/RF_C2: C312.1, C313.1, L306.2
/Radio 915MHz/RF_N: L302.1, U301.13 (RF_N)
/Radio 915MHz/RF_N1: C308.2, C310.1, L302.2, L303.2
/Radio 915MHz/RF_P: L301.1, U301.12 (RF_P)
/Radio 915MHz/RF_P1: C307.2, C308.1, L301.2, L304.1
/Radio 915MHz/X1: C301.1, U301.8 (XOSC_Q1), Y301.1
/Radio 915MHz/X2: C302.1, U301.10 (XOSC_Q2), Y301.3
GND: C301.2, C302.2, C303.2, C304.2, C305.2, C306.2, C307.1, C309.2, C311.2, R301.2, U301.16 (GND), U301.19 (GND), U301.21 (PAD), Y301.2, Y301.4; also elsewhere on the board
unnamed: C309.1, L303.1
unnamed: C312.2, L307.1
unnamed: C303.1, U301.5 (DCOUPL)
unnamed: R301.1, U301.17 (RBIAS)

Notes on the sheet:
Decoupling Capacitors
Oscillator
This circitis based on documentation of Texas Instruments. Later I will place the Application Note number.

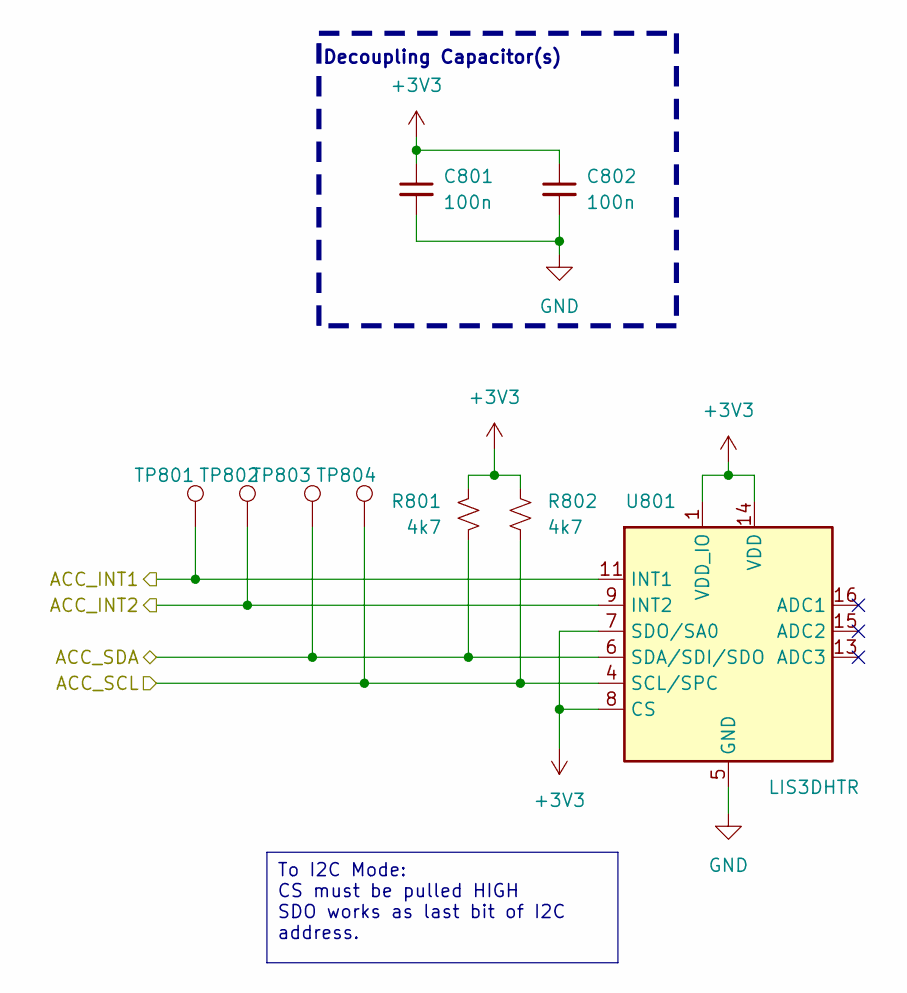
[picture p26: schematic accelerometer.kicad_sch, Project Antares - Transmitter Schematic]

Parts:
C801, C802: 100n; C_0603_1608Metric; LCSC C14663
R801, R802: 4k7; R_0603_1608Metric; LCSC C23162
TP801, TP802, TP803, TP804: TestPoint; TestPoint_Pad_D1.5mm
U801: LIS3DHTR; LGA-16_3x3mm_P0.5mm_LayoutBorder3x5y; LCSC C15134

Connections:
+3V3: C801.1, C802.1, R801.1, R802.1, U801.1 (VDD_IO), U801.7 (SDO/SA0), U801.8 (CS), U801.14 (VDD); also elsewhere on the board
/Accelerometer/ACC_INT1: TP801.1, U801.11 (INT1); also elsewhere on the board
/Accelerometer/ACC_INT2: TP802.1, U801.9 (INT2); also elsewhere on the board
/Accelerometer/ACC_SCL: R802.2, TP804.1, U801.4 (SCL/SPC); also elsewhere on the board
/Accelerometer/ACC_SDA: R801.2, TP803.1, U801.6 (SDA/SDI/SDO); also elsewhere on the board
GND: C801.2, C802.2, U801.5 (GND), U801.10 (GND), U801.12 (GND); also elsewhere on the board

Notes on the sheet:
Decoupling Capacitor(s)
To I2C Mode: CS must be pulled HIGH SDO works as last bit of I2C address.

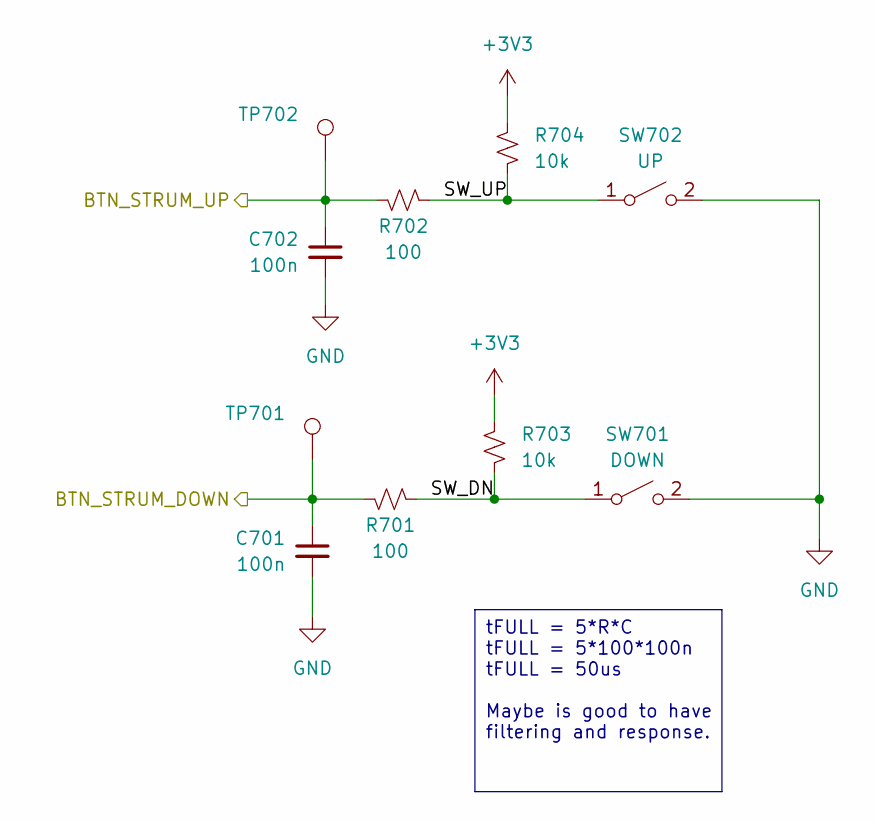
[picture p27: schematic strum.kicad_sch, Project Antares - Transmitter Schematic]

Parts:
C701, C702: 100n; C_0603_1608Metric; LCSC C14663
R701, R702: 100; R_0603_1608Metric; LCSC C22775
R703, R704: 10k; R_0603_1608Metric; LCSC C25804
SW701: DOWN; SW_Cherry_MX_1.00u_PCB; LCSC C404351
SW702: UP; SW_Cherry_MX_1.00u_PCB; LCSC C404351
TP701, TP702: TestPoint; TestPoint_Pad_D1.5mm

Connections:
+3V3: R703.1, R704.1; also elsewhere on the board
/MCU/BTN_STRUM_DOWN: C701.1, R701.1, TP701.1; also elsewhere on the board
/MCU/BTN_STRUM_UP: C702.1, R702.1, TP702.1; also elsewhere on the board
/Strum bar/SW_DN: R701.2, R703.2, SW701.1 (A)
/Strum bar/SW_UP: R702.2, R704.2, SW702.1 (A)
GND: C701.2, C702.2, SW701.2 (B), SW702.2 (B); also elsewhere on the board

Notes on the sheet:
tFULL = 5*R*C tFULL = 5*100*100n tFULL = 50us Maybe is good to have filtering and response.

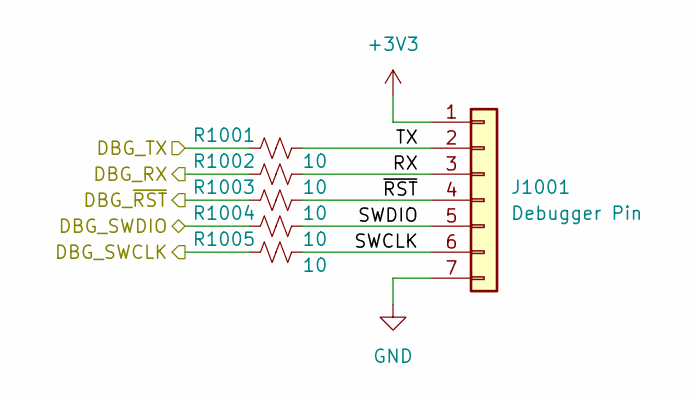
[picture p28: schematic debugging.kicad_sch, Project Antares - Transmitter Schematic]

Parts:
J1001: Debugger Pin; PinHeader_1x07_P2.54mm_Vertical
R1001, R1002, R1003, R1004, R1005: 10; R_0603_1608Metric; LCSC C22859

Connections:
+3V3: J1001.1; also elsewhere on the board
/Debugging/DBG_RX: R1002.1; also elsewhere on the board
/Debugging/DBG_SWCLK: R1005.1; also elsewhere on the board
/Debugging/DBG_SWDIO: R1004.1; also elsewhere on the board
/Debugging/DBG_TX: R1001.1; also elsewhere on the board
/Debugging/DBG_~RST: R1003.1; also elsewhere on the board
/Debugging/RX: J1001.3, R1002.2
/Debugging/SWCLK: J1001.6, R1005.2
/Debugging/SWDIO: J1001.5, R1004.2
/Debugging/TX: J1001.2, R1001.2
/Debugging/~RST: J1001.4, R1003.2
GND: J1001.7; also elsewhere on the board

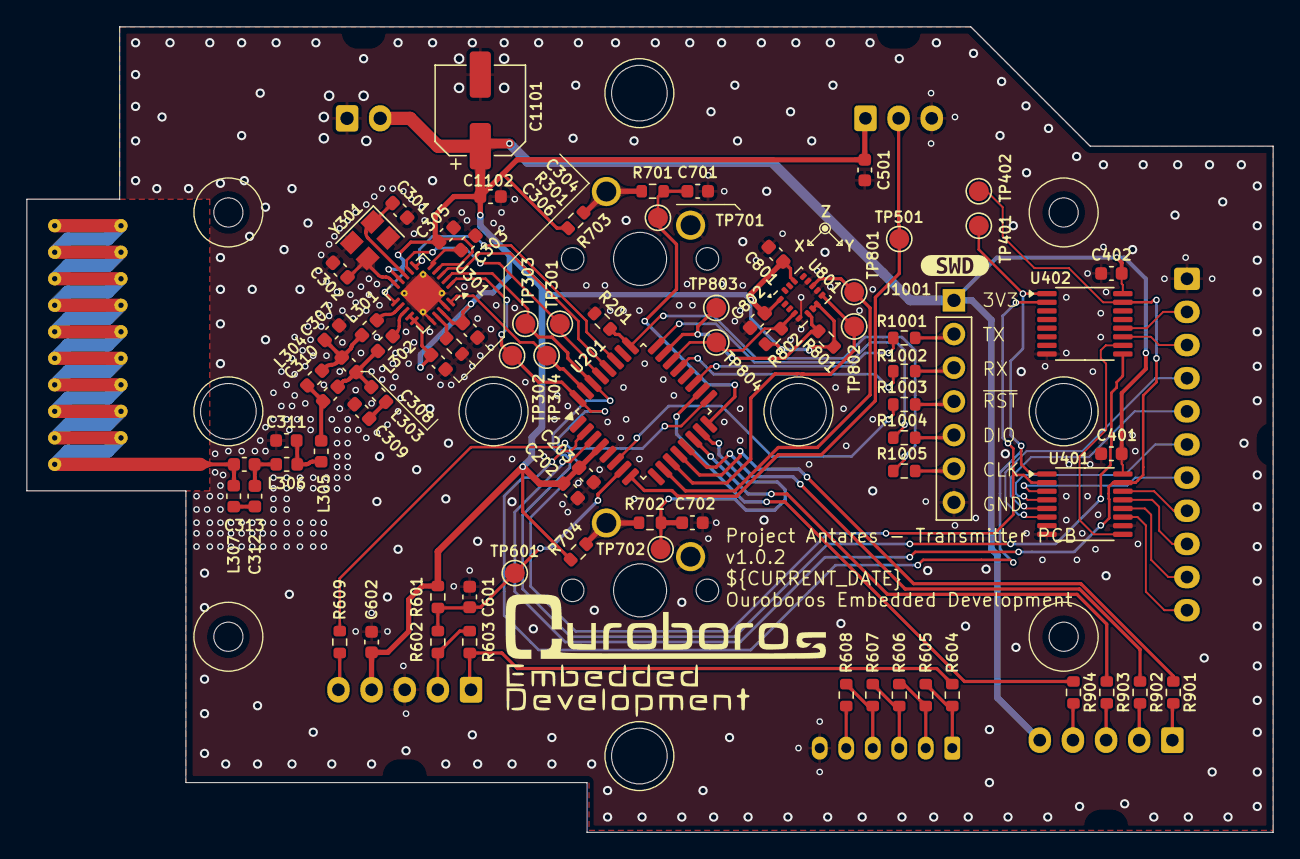
[picture p29: board Antares-Transmitter.kicad_pcb from above]

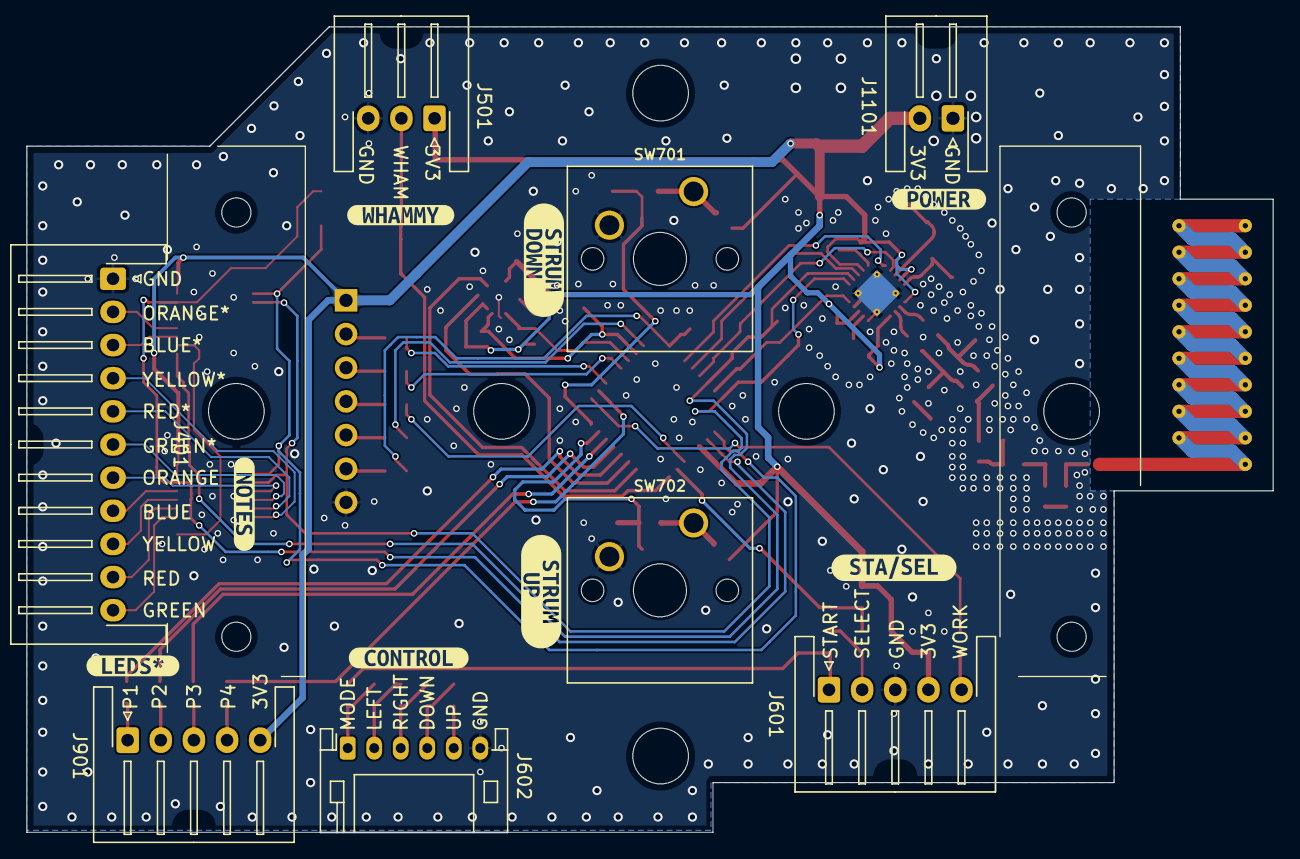
[picture p30: board Antares-Transmitter.kicad_pcb from below]

Board: 2 copper layers, 94.0 x 60.8 mm, 98 parts (16 on the bottom side), 72 nets.

Other parts of the board:
kibuzzard-66C9DF62: G***; kibuzzard-66C9DF62
kibuzzard-66C9DFEC: G***; kibuzzard-66C9DFEC
kibuzzard-66C9E0B9: G***; kibuzzard-66C9E0B9
kibuzzard-66C9E0F4: G***; kibuzzard-66C9E0F4
kibuzzard-66C9E01B: G***; kibuzzard-66C9E01B
kibuzzard-66C9E05B: G***; kibuzzard-66C9E05B
kibuzzard-66C9E07F: G***; kibuzzard-66C9E07F
kibuzzard-66C9E09D: G***; kibuzzard-66C9E09D
kibuzzard-66C9E100: G***; kibuzzard-66C9E100
