Pablo-Jean/Antares-Transmitter-HWR/(commit log)

2024-08-24 :tada: first commit
    [Antares-Transmitter.kicad_pcb, Antares-Transmitter.kicad_sch, Notes Btn An Calculations.ods, accelerometer.kicad_sch, control_buttons.kicad_sch, debugging.kicad_sch, leds.kicad_sch, mcu.kicad_sch]
2024-08-24 :package: finished version 1.0.0, generated production files
    [Antares-Transmitter-B_Cu.gbr, Antares-Transmitter-B_Mask.gbr, Antares-Transmitter-B_Paste.gbr, Antares-Transmitter-B_Silkscreen.gbr, Antares-Transmitter-Edge_Cuts.gbr, Antares-Transmitter-F_Cu.gbr, Antares-Transmitter-F_Mask.gbr, Antares-Transmitter-F_Paste.gbr]
2024-08-24 t:art: fixed noted reading, using 75hc165 for Input expander
    [Antares-Transmitter.kicad_pcb, Antares-Transmitter.kicad_sch, Bill of Materials.csv, accelerometer.kicad_sch, control_buttons.kicad_sch, debugging.kicad_sch, leds.kicad_sch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]
2024-08-24 :package: generated v1.0.1 production files
    [Antares-Transmitter-B_Cu.gbr, Antares-Transmitter-B_Mask.gbr, Antares-Transmitter-B_Paste.gbr, Antares-Transmitter-B_Silkscreen.gbr, Antares-Transmitter-Edge_Cuts.gbr, Antares-Transmitter-F_Cu.gbr, Antares-Transmitter-F_Mask.gbr, Antares-Transmitter-F_Paste.gbr]
2024-08-24 fixed reference designator BOM export
    [Antares-Transmitter.kicad_pcb]
2024-08-25 :minidisc: fixed some silkscreen, added vias and updated LCSC PNs with Basic components
    [Antares-Transmitter-B_Cu.gbr, Antares-Transmitter-B_Mask.gbr, Antares-Transmitter-B_Paste.gbr, Antares-Transmitter-B_Silkscreen.gbr, Antares-Transmitter-Edge_Cuts.gbr, Antares-Transmitter-F_Cu.gbr, Antares-Transmitter-F_Mask.gbr, Antares-Transmitter-F_Paste.gbr]
2024-08-26 fixed v1.0.2 pcb and files
    [Antares-Transmitter-B_Cu.gbr, Antares-Transmitter-B_Mask.gbr, Antares-Transmitter-B_Paste.gbr, Antares-Transmitter-B_Silkscreen.gbr, Antares-Transmitter-Edge_Cuts.gbr, Antares-Transmitter-F_Cu.gbr, Antares-Transmitter-F_Mask.gbr, Antares-Transmitter-F_Paste.gbr]
2024-09-04 :memo: added schematic model
    [mcu.kicad_sch, radio.kicad_sch]
2025-12-22 small fixes
    [Antares-Transmitter.kicad_pcb, Antares-Transmitter.kicad_sch, accelerometer.kicad_sch, control_buttons.kicad_sch, debugging.kicad_sch, leds.kicad_sch, mcu.kicad_sch, notes.kicad_sch]
